xinyew/Moamoa_CPAP_PI_hardware/kmm-pmask-control/exports/kmm-pmask-control.pdf

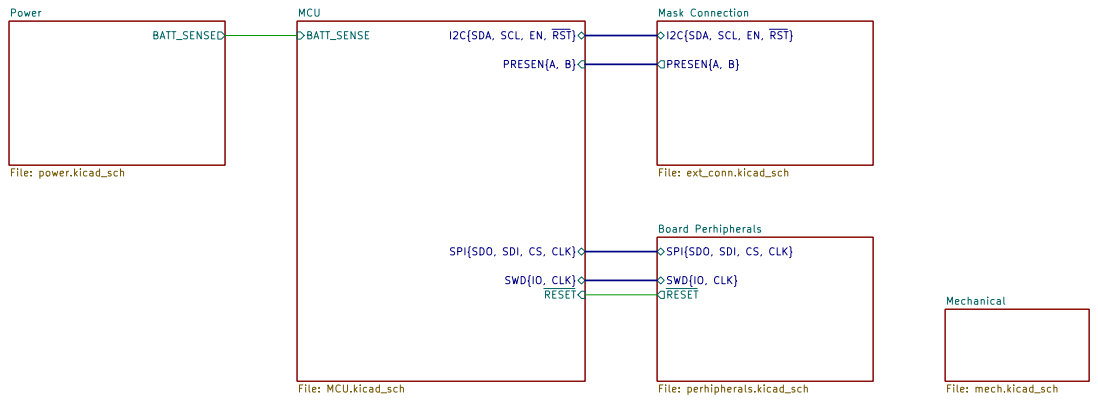
[picture p1: page 1]

SWD{IO, CLK} RESET PRESEN{A, B} BATT_SENSE MCU

I2C{SDA, SCL, EN, RST}

File: ext_conn.kicad_sch SPI{SDO, SDI, CS, CLK}

SWD{IO, CLK} RESET Board Perhipherals File: perhipherals.kicad_sch

SPI{SDO, SDI, CS, CLK}

Aiden Lee [piman PCB]
Ka Moamoa Lab, Georgia Institute of Technology
Sheet: /
File: kmm-pmask-control.kicad_sch
Title: Patient Monitoring Mask Control Board

Size: A4 | Rev: 2.0
KiCad E.D.A. 10.0.4 | Id: 1/6

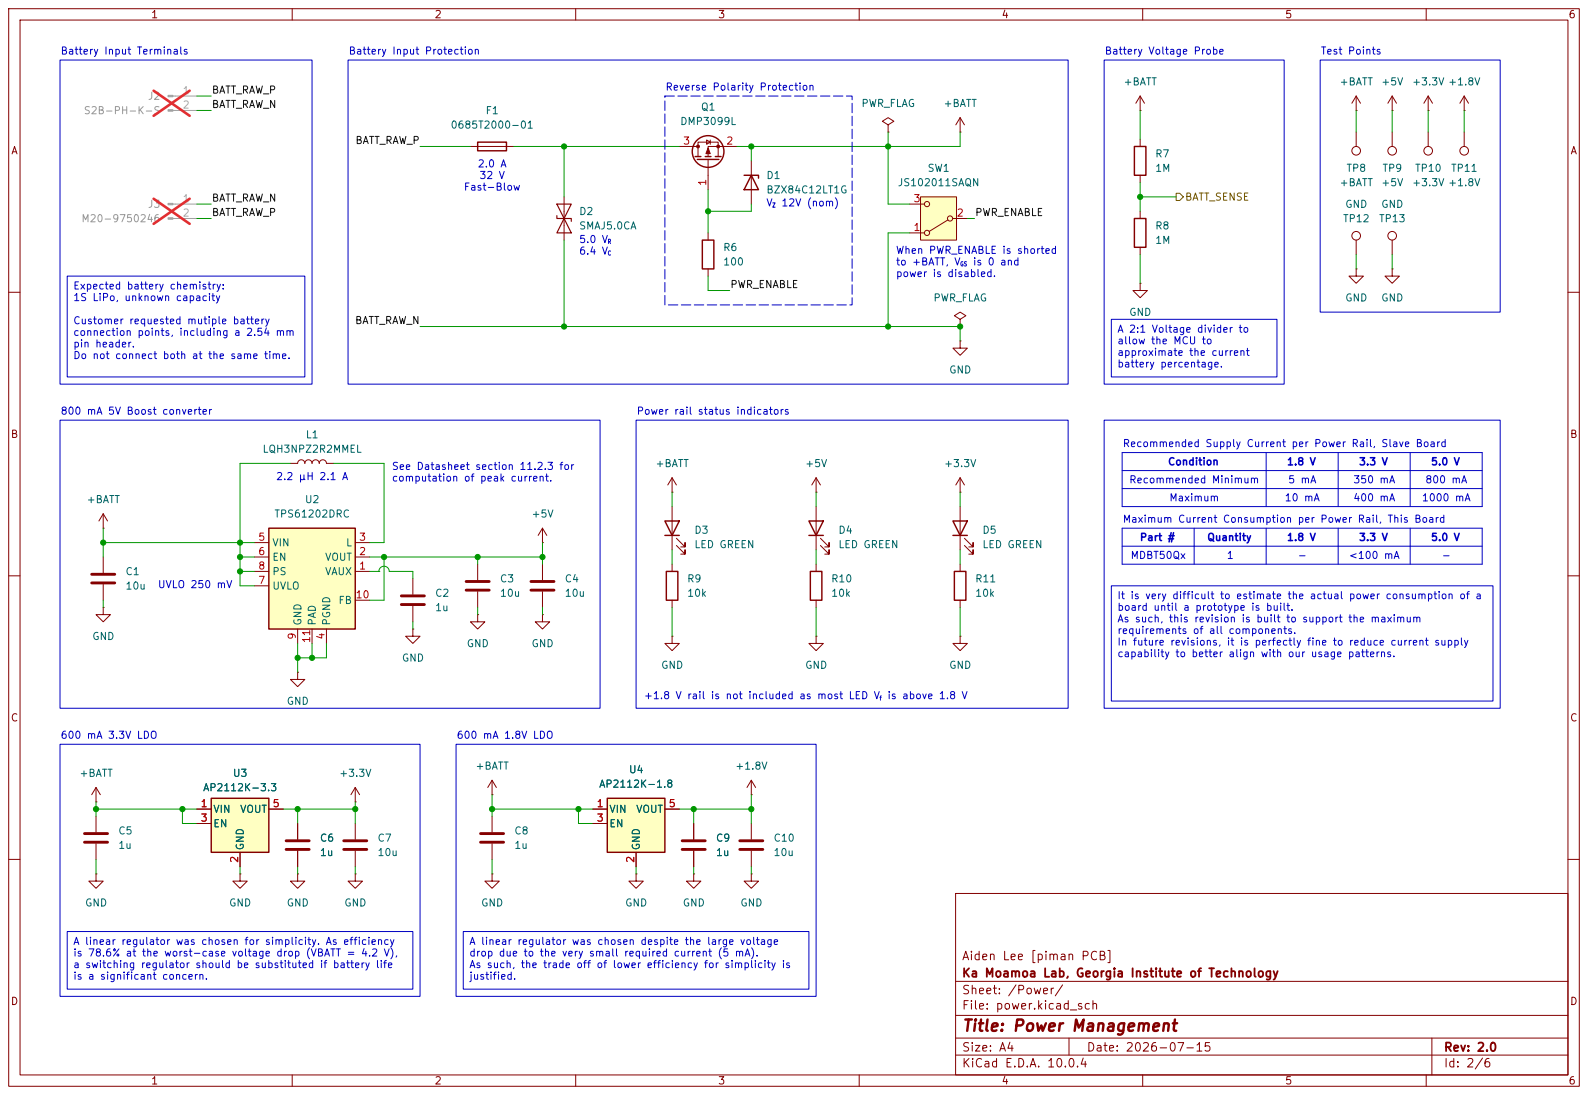
[picture p2: page 2]

to +BATT, VGS is 0 and

power is disabled. 600 mA 1.8V LDO

Expected battery chemistry: 1S LiPo, unknown capacity Customer requested mutiple battery connection points, including a 2.54 mm

GND
A 2:1 Voltage divider to
allow the MCU to

approximate the current battery percentage. A linear regulator was chosen for simplicity. As efficiency

Aiden Lee [piman PCB] C3

It is very difficult to estimate the actual power consumption of a
board until a prototype is built. As such, this revision is built to support the maximum

requirements of all components.
In future revisions, it is perfectly fine to reduce current supply

capability to better align with our usage patterns. A linear regulator was chosen despite the large voltage

is 78.6% at the worst-case voltage drop (VBATT = 4.2 V), a switching regulator should be substituted if battery life

drop due to the very small required current (5 mA). As such, the trade off of lower efficiency for simplicity is

Ka Moamoa Lab, Georgia Institute of Technology
Sheet: /Power/
File: power.kicad_sch
Title: Power Management

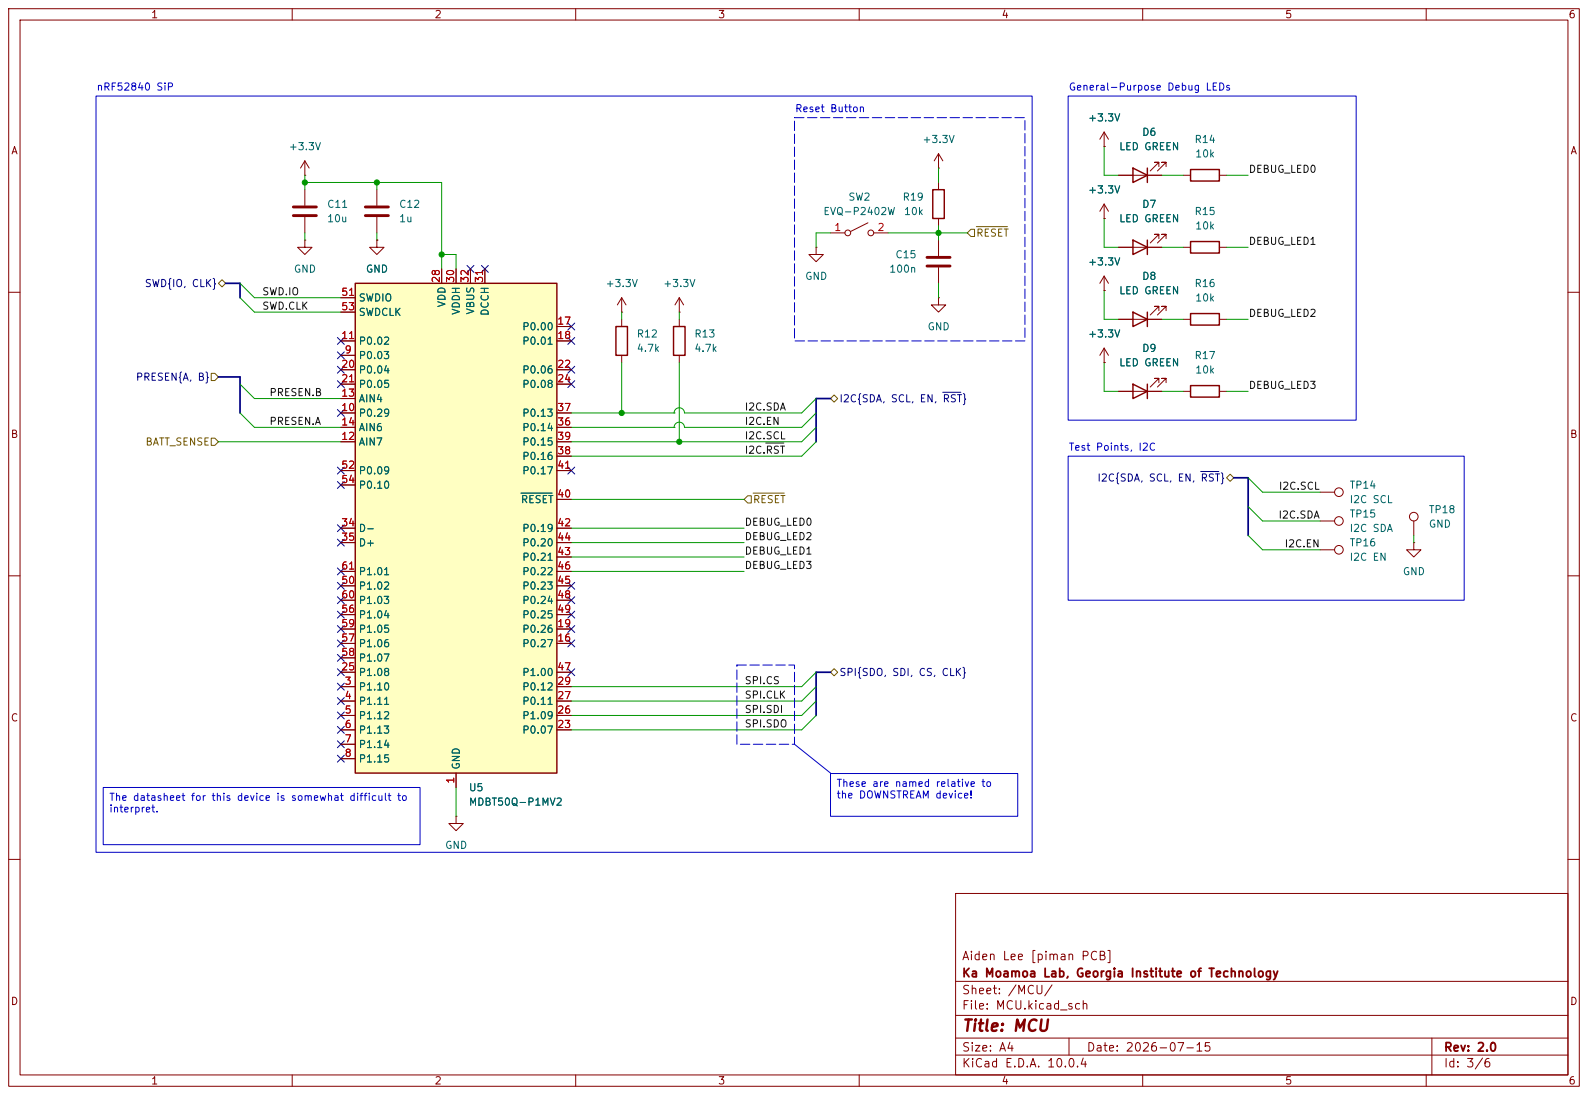
[picture p3: page 3]

I2C{SDA, SCL, EN, RST} SWD.IO
I2C.SCL SWD.CLK

I2C{SDA, SCL, EN, RST}

These are named relative to

Aiden Lee [piman PCB]
Ka Moamoa Lab, Georgia Institute of Technology
Sheet: /MCU/
File: MCU.kicad_sch
Title: MCU

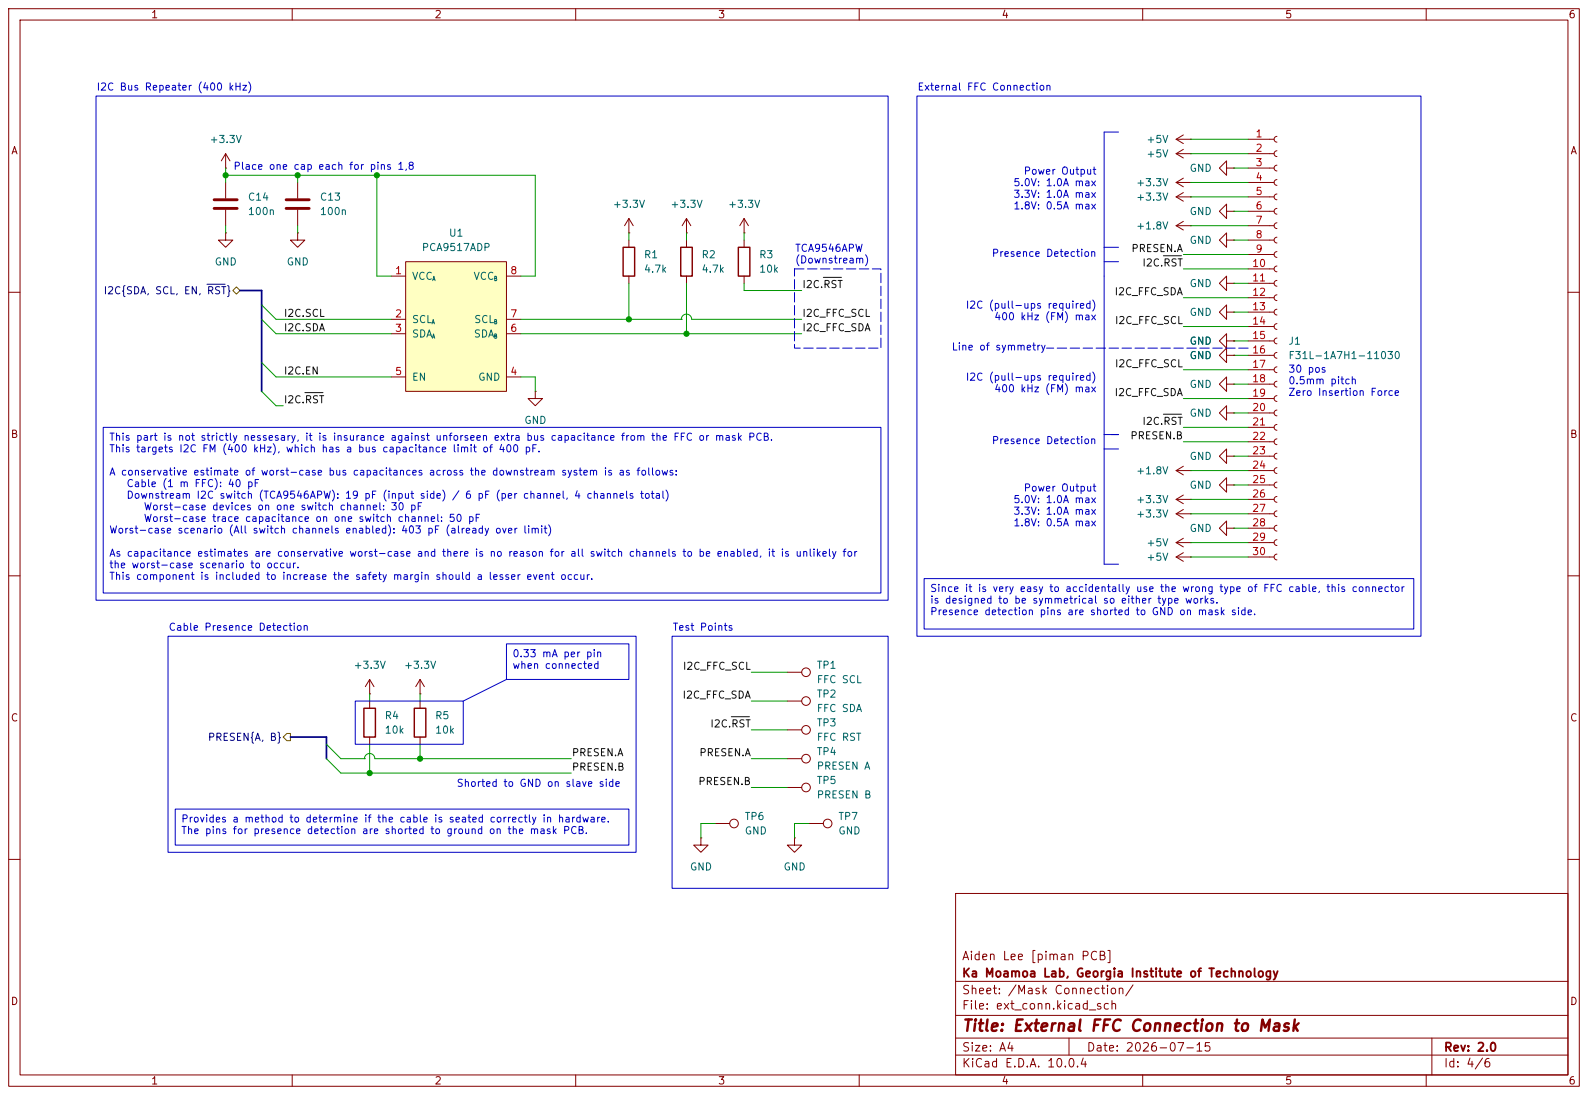
[picture p4: page 4]

(Downstream) Shorted to GND on slave side

I2C{SDA, SCL, EN, RST}

I2C_FFC_SDA Provides a method to determine if the cable is seated correctly in hardware. The pins for presence detection are shorted to ground on the mask PCB. 0.33 mA per pin when connected

I2C (pull-ups required) 400 kHz (FM) max Power Output 5.0V: 1.0A max 3.3V: 1.0A max 1.8V: 0.5A max

This part is not strictly nessesary, it is insurance against unforseen extra bus capacitance from the FFC or mask PCB. This targets I2C FM (400 kHz), which has a bus capacitance limit of 400 pF. A conservative estimate of worst-case bus capacitances across the downstream system is as follows: Cable (1 m FFC): 40 pF Downstream I2C switch (TCA9546APW): 19 pF (input side) / 6 pF (per channel, 4 channels total) Worst-case devices on one switch channel: 30 pF Worst-case trace capacitance on one switch channel: 50 pF Worst-case scenario (All switch channels enabled): 403 pF (already over limit) As capacitance estimates are conservative worst-case and there is no reason for all switch channels to be enabled, it is unlikely for

is designed to be symmetrical so either type works. Presence detection pins are shorted to GND on mask side. Test Points

Aiden Lee [piman PCB]
Ka Moamoa Lab, Georgia Institute of Technology
Sheet: /Mask Connection/
File: ext_conn.kicad_sch
Title: External FFC Connection to Mask

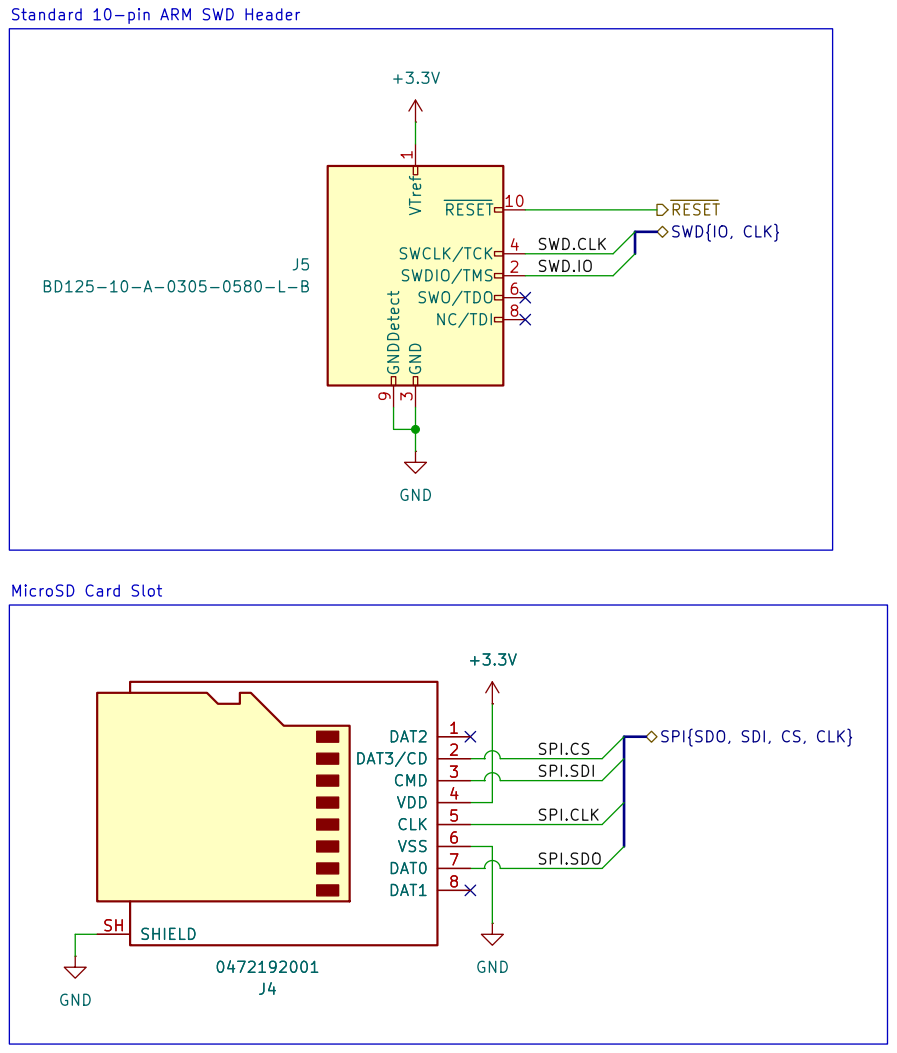
[picture p5: page 5]

SWD{IO, CLK} RESET SPI.CS

Aiden Lee [piman PCB] +3.3V GND

SPI{SDO, SDI, CS, CLK}

SPI.SDI SPI.CLK

Ka Moamoa Lab, Georgia Institute of Technology
Sheet: /Board Perhipherals/
File: perhipherals.kicad_sch
Title: On-Board Perhipherals

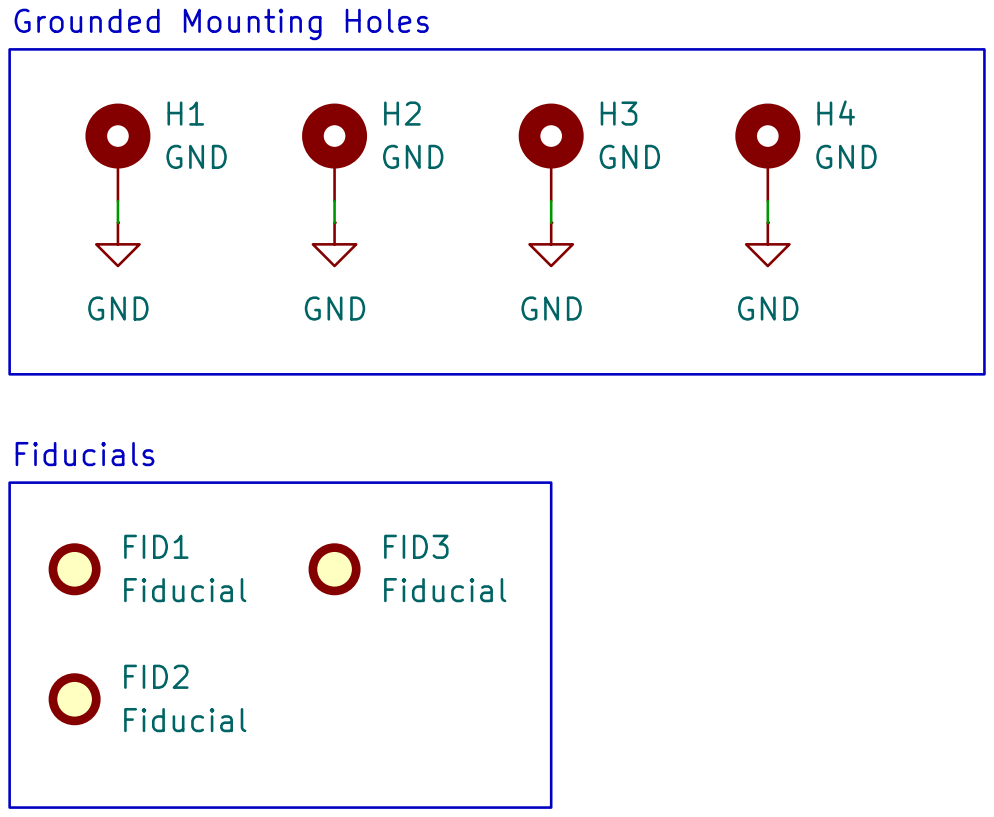
[picture p6: page 6]

Grounded Mounting Holes Fiducials

Aiden Lee [piman PCB]
Ka Moamoa Lab, Georgia Institute of Technology
Sheet: /Mechanical/
File: mech.kicad_sch
Title:
