xinyew/Moamoa_CPAP_PI_hardware/kmm-pmask-mask/exports/kmm-pmask-mask.pdf

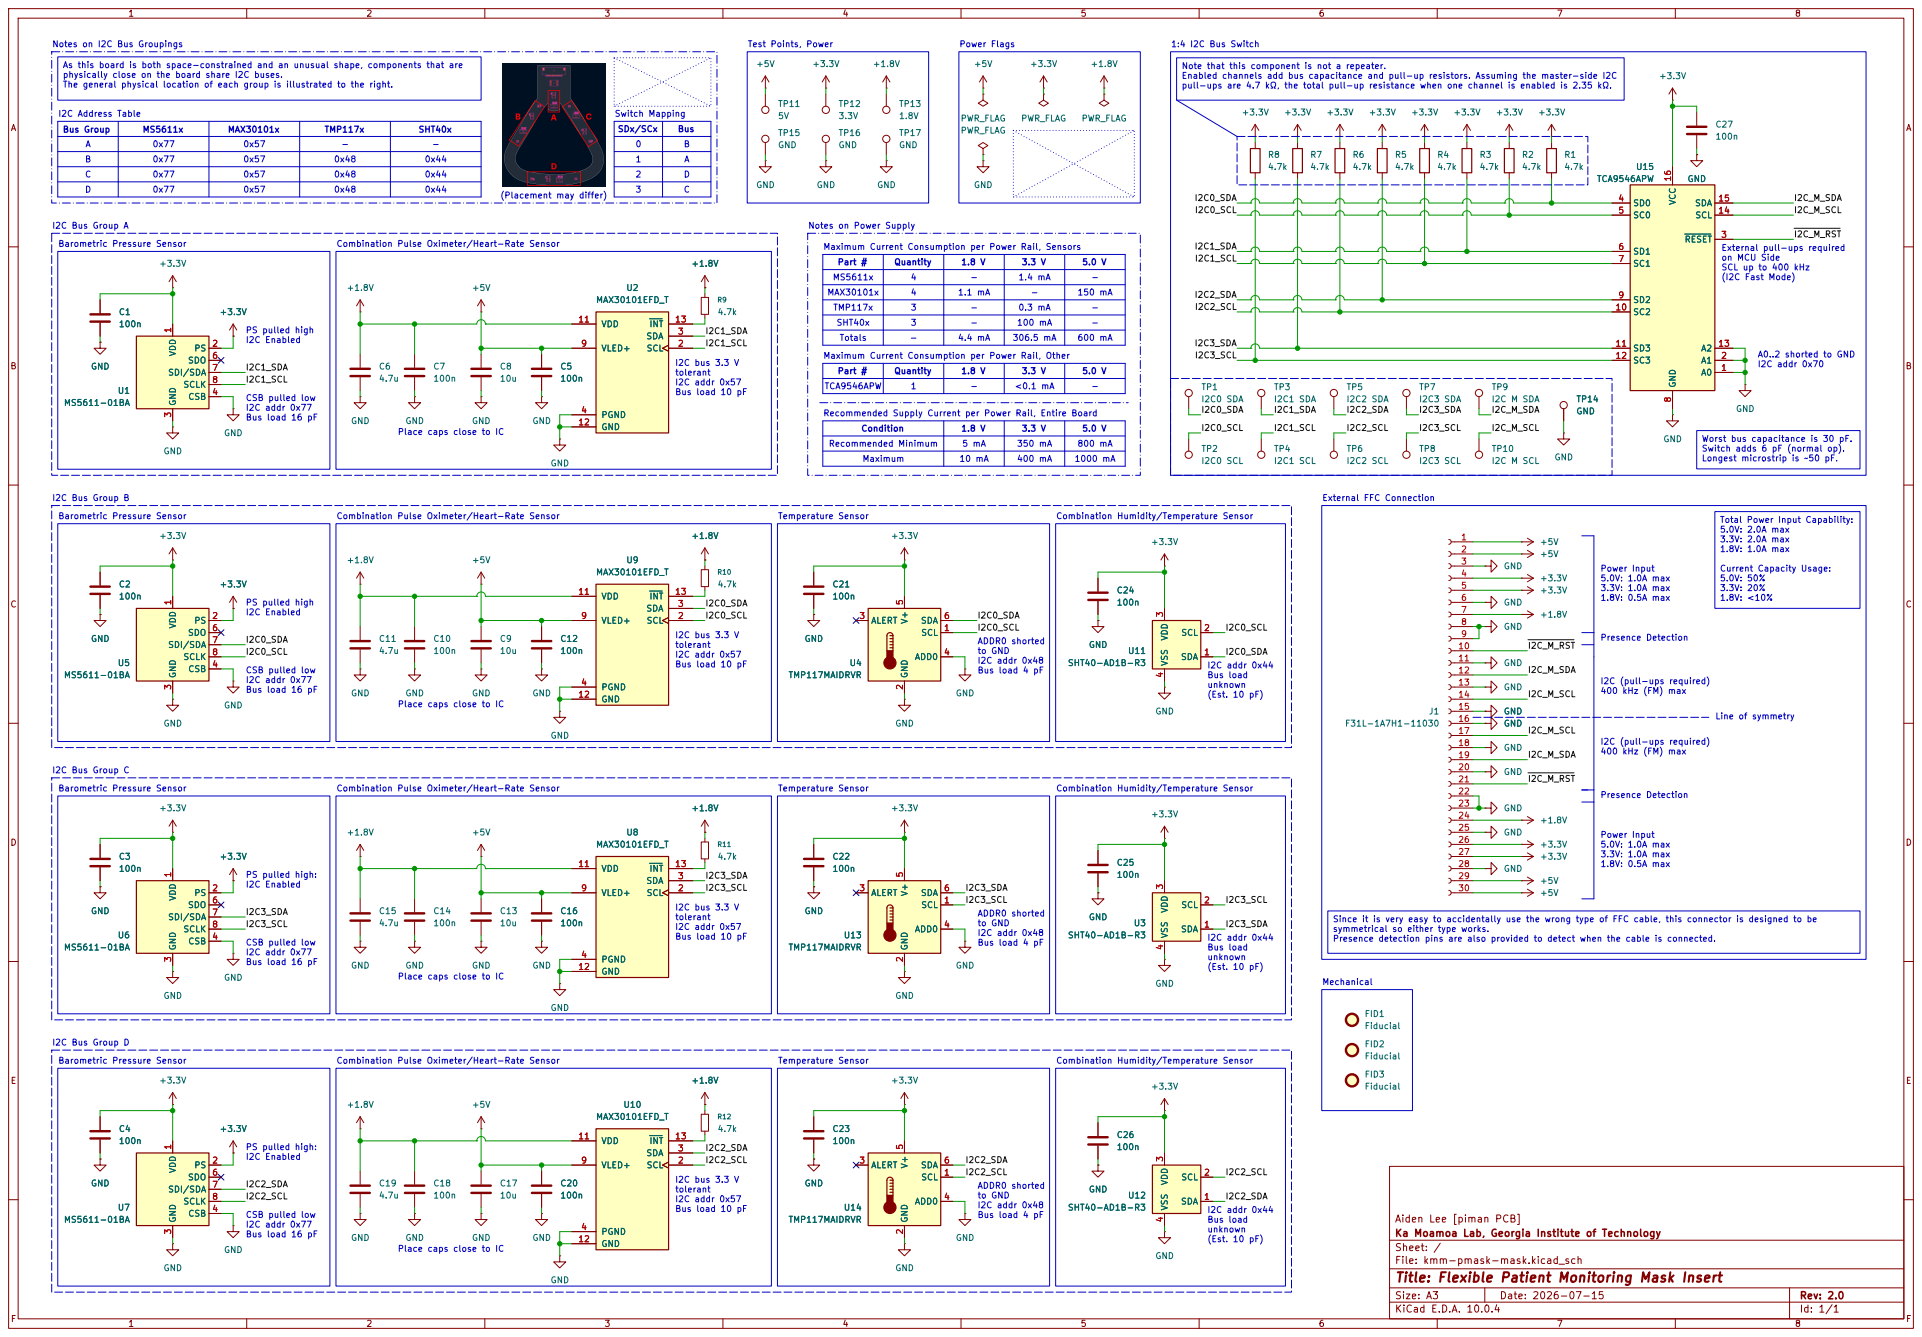
[picture p7: page 1]

Notes on I2C Bus Groupings

Power Flags Maximum Current Consumption per Power Rail, Sensors Maximum Current Consumption per Power Rail, Other

As this board is both space-constrained and an unusual shape, components that are physically close on the board share I2C buses. The general physical location of each group is illustrated to the right.

Longest microstrip is ~50 pF. Note that this component is not a repeater. Enabled channels add bus capacitance and pull-up resistors. Assuming the master-side I2C

(Placement may differ)
GND +3.3V C1
I2C Enabled PS pulled high
I2C Enabled CSB pulled low

Part # | Quantity 4 | 1.8 V - | 1.4 mA 3.3 V | 5.0 V MS5611x -

on MCU Side SCL up to 400 kHz

(I2C Fast Mode) A0..2 shorted to GND

MAX30101x | 4 | 1.1 mA | - | 150 mA

I2C addr 0x70 Place caps close to IC
100n GND

Recommended Supply Current per Power Rail, Entire Board

(Est. 10 pF) Combination Humidity/Temperature Sensor

Line of symmetry Presence Detection Power Input 5.0V: 1.0A max 3.3V: 1.0A max 1.8V: 0.5A max Presence Detection Power Input 5.0V: 1.0A max 3.3V: 1.0A max 1.8V: 0.5A max

I2C addr 0x57 Bus load 10 pF Barometric Pressure Sensor

I2C (pull-ups required) 400 kHz (FM) max

Place caps close to IC

Combination Pulse Oximeter/Heart-Rate Sensor PS pulled high:

I2C bus 3.3 V
tolerant
I2C addr 0x57 Bus load 10 pF

Since it is very easy to accidentally use the wrong type of FFC cable, this connector is designed to be
symmetrical so either type works. Presence detection pins are also provided to detect when the cable is connected.

Combination Pulse Oximeter/Heart-Rate Sensor

Aiden Lee [piman PCB] C18

to GND
I2C addr 0x48 Bus load 4 pF

unknown (Est. 10 pF)

Ka Moamoa Lab, Georgia Institute of Technology
Sheet: /
File: kmm-pmask-mask.kicad_sch
Title: Flexible Patient Monitoring Mask Insert

Size: A3 | Rev: 2.0 | F Date: 2026-07-15
KiCad E.D.A. 10.0.4 | Id: 1/1
