xinyew/Moamoa_CPAP_PI_hardware/kmm-pmask-mask-M/kmm-pmask-mask.kicad_pcb

## KiCad design kmm-pmask-mask-M/kmm-pmask-mask.kicad_pcb (2026-08-24)

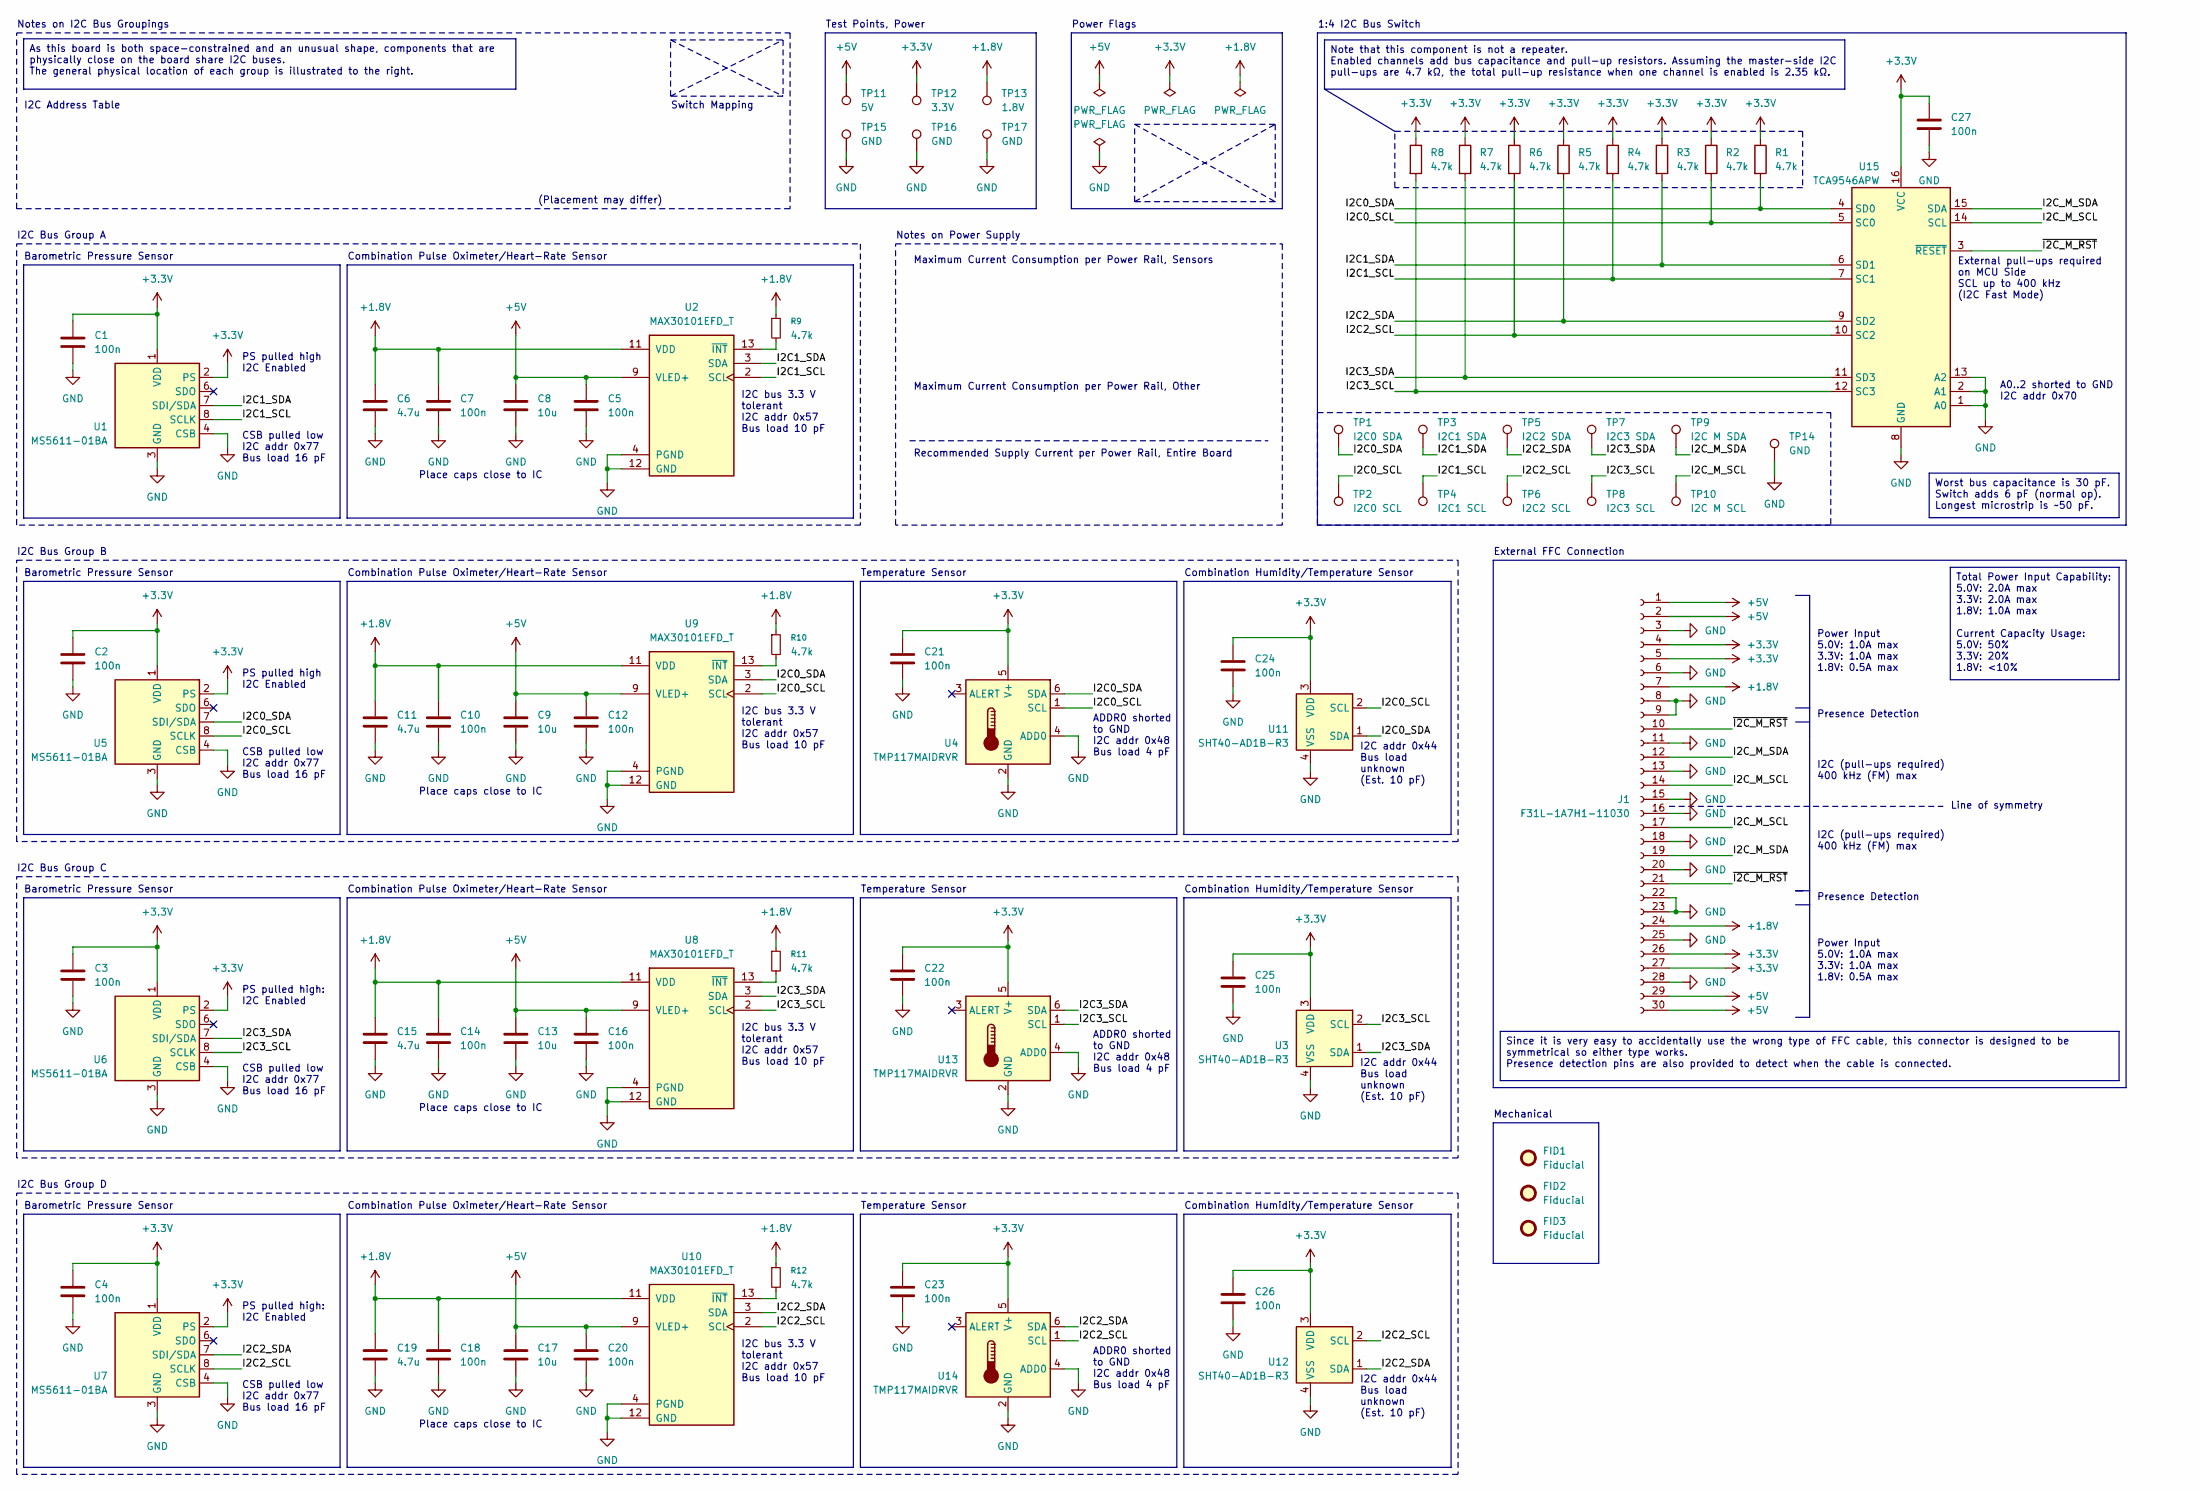
[picture p8: schematic kmm-pmask-mask.kicad_sch, Flexible Patient Monitoring Mask Insert]

Parts:
C1, C2, C3, C4, C5, C7, C10, C12, C14, C16, C18, C20, C21, C22, C23, C24, C25, C26, C27: 100n; C_0201_0603Metric_Pad0.64x0.40mm_HandSolder
C6, C11, C15, C19: 4.7u; C_0402_1005Metric_Pad0.74x0.62mm_HandSolder
C8, C9, C13, C17: 10u; C_0402_1005Metric_Pad0.74x0.62mm_HandSolder
FID1, FID2, FID3: Fiducial; Fiducial_1mm_Mask3mm
J1: F31L-1A7H1-11030; AMPHENOL_F31L-1A7H1-11030; Manufacturer P/N F31L-1A7H1-11030
R1, R2, R3, R4, R5, R6, R7, R8, R9, R10, R11, R12: 4.7k; R_0201_0603Metric_Pad0.64x0.40mm_HandSolder
TP1: I2C0 SDA; TestPoint_Pad_D1.0mm
TP2: I2C0 SCL; TestPoint_Pad_D1.0mm
TP3: I2C1 SDA; TestPoint_Pad_D1.0mm
TP4: I2C1 SCL; TestPoint_Pad_D1.0mm
TP5: I2C2 SDA; TestPoint_Pad_D1.0mm
TP6: I2C2 SCL; TestPoint_Pad_D1.0mm
TP7: I2C3 SDA; TestPoint_Pad_D1.0mm
TP8: I2C3 SCL; TestPoint_Pad_D1.0mm
TP9: I2C M SDA; TestPoint_Pad_D1.0mm
TP10: I2C M SCL; TestPoint_Pad_D1.0mm
TP11: 5V; TestPoint_Pad_D1.0mm
TP12: 3.3V; TestPoint_Pad_D1.0mm
TP13: 1.8V; TestPoint_Pad_D1.0mm
TP14, TP15, TP16, TP17: GND; TestPoint_Pad_D1.0mm
U1, U5, U6, U7: MS5611-01BA; LGA-8_3x5mm_P1.25mm; Manufacturer P/N MS561101BA03-50
U2, U8, U9, U10: MAX30101EFD_T; Manufacturer P/N MAX30101EFD+T
U3, U11, U12: SHT40-AD1B-R3; Sensirion_DFN-4_1.5x1.5mm_P0.8mm_SHT4x_NoCentralPad; Manufacturer P/N SHT40-AD1B-R3
U4, U13, U14: TMP117MAIDRVR; WSON-6-1EP_2x2mm_P0.65mm_EP1x1.6mm; Manufacturer P/N TMP117MAIDRVR
U15: TCA9546APW; TSSOP-16_4.4x5mm_P0.65mm; Manufacturer P/N TCA9546APWR

Connections:
+1.8V: C6.1, C7.1, C10.1, C11.1, C14.1, C15.1, C18.1, C19.1, J1.7, J1.24, R9.1, R10.1, R11.1, R12.1, TP13.1 (1_1), U2.11 (VDD), U8.11 (VDD), U9.11 (VDD), U10.11 (VDD)
+3.3V: C1.1, C2.1, C3.1, C4.1, C21.1, C22.1, C23.1, C24.1, C25.1, C26.1, C27.1, J1.4, J1.5, J1.26, J1.27, R1.1, R2.1, R3.1, R4.1, R5.1, R6.1, R7.1, R8.1, TP12.1 (1_1), U1.1 (VDD), U1.2 (PS), U3.3 (VDD), U4.5 (V+), U5.1 (VDD), U5.2 (PS), U6.1 (VDD), U6.2 (PS), U7.1 (VDD), U7.2 (PS), U11.3 (VDD), U12.3 (VDD), U13.5 (V+), U14.5 (V+), U15.16 (VCC)
+5V: C5.1, C8.1, C9.1, C12.1, C13.1, C16.1, C17.1, C20.1, J1.1, J1.2, J1.29, J1.30, TP11.1 (1_1), U2.9 (VLED+), U2.10 (VLED+), U8.9 (VLED+), U8.10 (VLED+), U9.9 (VLED+), U9.10 (VLED+), U10.9 (VLED+), U10.10 (VLED+)
/I2C0_SCL: R2.2, TP2.1 (1_1), U4.1 (SCL), U5.8 (SCLK), U9.2 (SCL), U11.2 (SCL), U15.5 (SC0)
/I2C0_SDA: R1.2, TP1.1 (1_1), U4.6 (SDA), U5.7 (SDI/SDA), U9.3 (SDA), U11.1 (SDA), U15.4 (SD0)
/I2C1_SCL: R4.2, TP4.1 (1_1), U1.8 (SCLK), U2.2 (SCL), U15.7 (SC1)
/I2C1_SDA: R3.2, TP3.1 (1_1), U1.7 (SDI/SDA), U2.3 (SDA), U15.6 (SD1)
/I2C2_SCL: R6.2, TP6.1 (1_1), U7.8 (SCLK), U10.2 (SCL), U12.2 (SCL), U14.1 (SCL), U15.10 (SC2)
/I2C2_SDA: R5.2, TP5.1 (1_1), U7.7 (SDI/SDA), U10.3 (SDA), U12.1 (SDA), U14.6 (SDA), U15.9 (SD2)
/I2C3_SCL: R8.2, TP8.1 (1_1), U3.2 (SCL), U6.8 (SCLK), U8.2 (SCL), U13.1 (SCL), U15.12 (SC3)
/I2C3_SDA: R7.2, TP7.1 (1_1), U3.1 (SDA), U6.7 (SDI/SDA), U8.3 (SDA), U13.6 (SDA), U15.11 (SD3)
/I2C_M_SCL: J1.14, J1.17, TP10.1 (1_1), U15.14 (SCL)
/I2C_M_SDA: J1.12, J1.19, TP9.1 (1_1), U15.15 (SDA)
/~I2C_M_RST: J1.10, J1.21, U15.3 (~RESET)
GND: C1.2, C2.2, C3.2, C4.2, C5.2, C6.2, C7.2, C8.2, C9.2, C10.2, C11.2, C12.2, C13.2, C14.2, C15.2, C16.2, C17.2, C18.2, C19.2, C20.2, C21.2, C22.2, C23.2, C24.2, C25.2, C26.2, C27.2, J1.3, J1.6, J1.8, J1.9, J1.11, J1.13, J1.15, J1.16, J1.18, J1.20, J1.22, J1.23, J1.25, J1.28, TP14.1 (1_1), TP15.1 (1_1), TP16.1 (1_1), TP17.1 (1_1), U1.3 (GND), U1.4 (CSB), U1.5 (CSB), U2.4 (PGND), U2.12 (GND), U3.4 (VSS), U4.2 (GND), U4.4 (ADD0), U5.3 (GND), U5.4 (CSB), U5.5 (CSB), U6.3 (GND), U6.4 (CSB), U6.5 (CSB), U7.3 (GND), U7.4 (CSB), U7.5 (CSB), U8.4 (PGND), U8.12 (GND), U9.4 (PGND), U9.12 (GND), U10.4 (PGND), U10.12 (GND), U11.4 (VSS), U12.4 (VSS), U13.2 (GND), U13.4 (ADD0), U14.2 (GND), U14.4 (ADD0), U15.1 (A0), U15.2 (A1), U15.8 (GND), U15.13 (A2)
unnamed: R9.2, U2.13 (~INT)
unnamed: R11.2, U8.13 (~INT)
unnamed: R10.2, U9.13 (~INT)
unnamed: R12.2, U10.13 (~INT)

Notes on the sheet:
Switch Mapping
I2C (pull-ups required) 400 kHz (FM) max
1:4 I2C Bus Switch
Barometric Pressure Sensor
CSB pulled low I2C addr 0x77 Bus load 16 pF
PS pulled high I2C Enabled
Test Points, Power
ADDR0 shorted to GND I2C addr 0x48 Bus load 4 pF
Temperature Sensor
I2C bus 3.3 V tolerant I2C addr 0x57 Bus load 10 pF
(Placement may differ)
Presence Detection
Notes on Power Supply
I2C Bus Group C
Place caps close to IC
Combination Pulse Oximeter/Heart-Rate Sensor
External FFC Connection
Power Input 5.0V: 1.0A max 3.3V: 1.0A max 1.8V: 0.5A max
Maximum Current Consumption per Power Rail, Sensors
I2C Bus Group D
I2C Bus Group B
I2C addr 0x44 Bus load unknown (Est. 10 pF)
PS pulled high: I2C Enabled
Power Flags
Maximum Current Consumption per Power Rail, Other
Combination Humidity/Temperature Sensor
Line of symmetry
Recommended Supply Current per Power Rail, Entire Board
I2C Bus Group A
Mechanical
External pull-ups required on MCU Side SCL up to 400 kHz (I2C Fast Mode)
Notes on I2C Bus Groupings
I2C Address Table
A0..2 shorted to GND I2C addr 0x70
Since it is very easy to accidentally use the wrong type of FFC cable, this connector is designed to be symmetrical so either type works. Presence detection pins are also provided to detect when the cable is connected.
As this board is both space-constrained and an unusual shape, components that are physically close on the board share I2C buses. The general physical location of each group is illustrated to the right.
Note that this component is not a repeater. Enabled channels add bus capacitance and pull-up resistors. Assuming the master-side I2C pull-ups are 4.7 kΩ, the total pull-up resistance when one channel is enabled is 2.35 kΩ.
Total Power Input Capability: 5.0V: 2.0A max 3.3V: 2.0A max 1.8V: 1.0A max Current Capacity Usage: 5.0V: 50% 3.3V: 20% 1.8V: <10%
Worst bus capacitance is 30 pF. Switch adds 6 pF (normal op). Longest microstrip is ~50 pF.

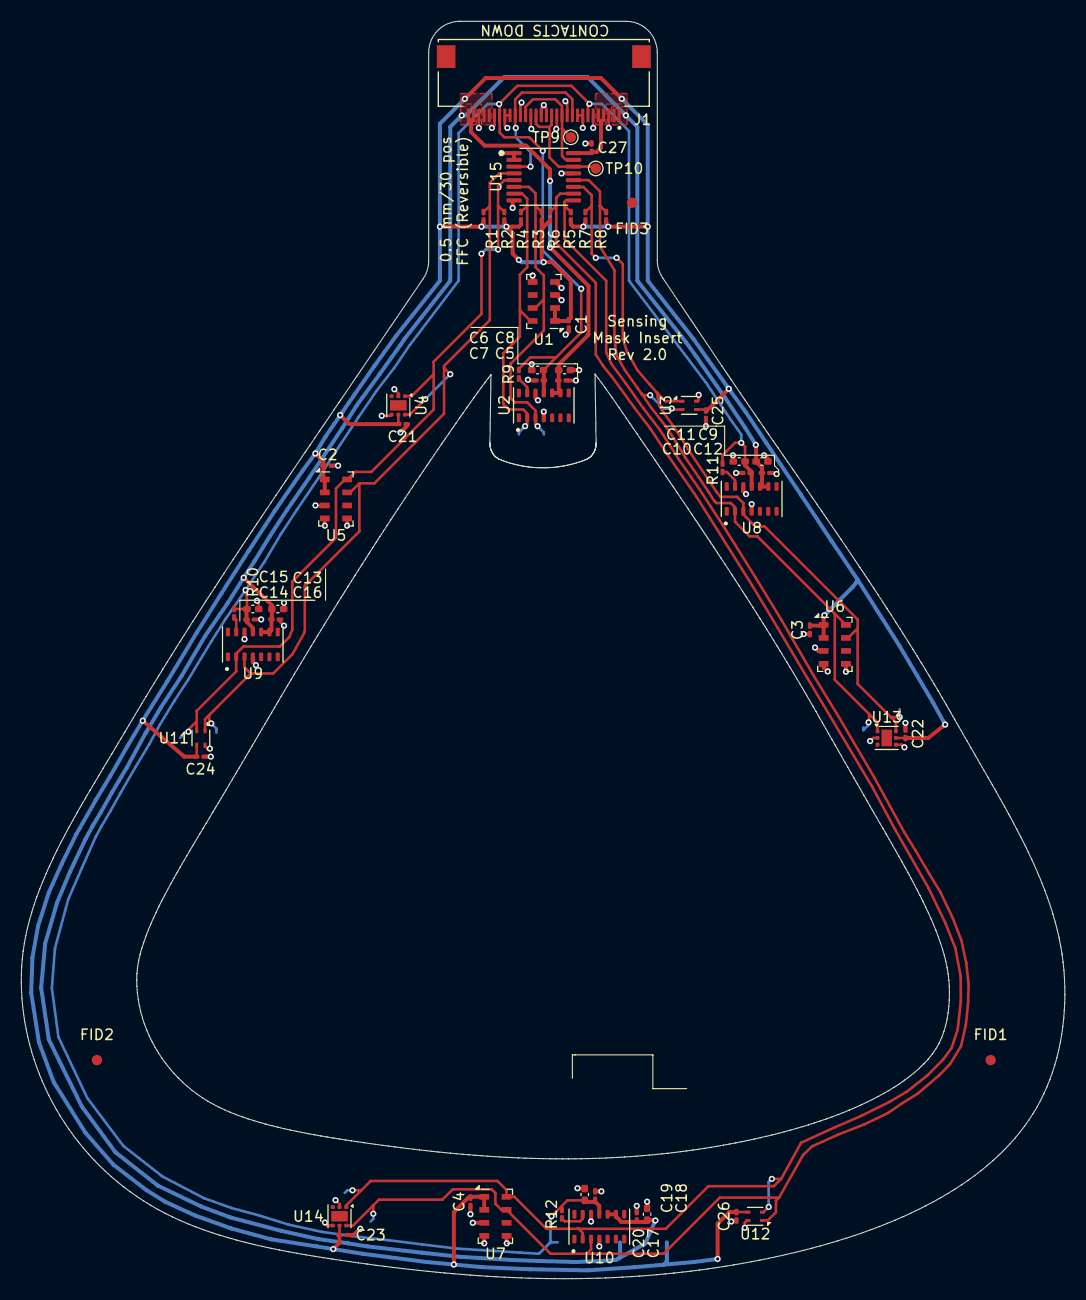
[picture p9: board kmm-pmask-mask.kicad_pcb from above]

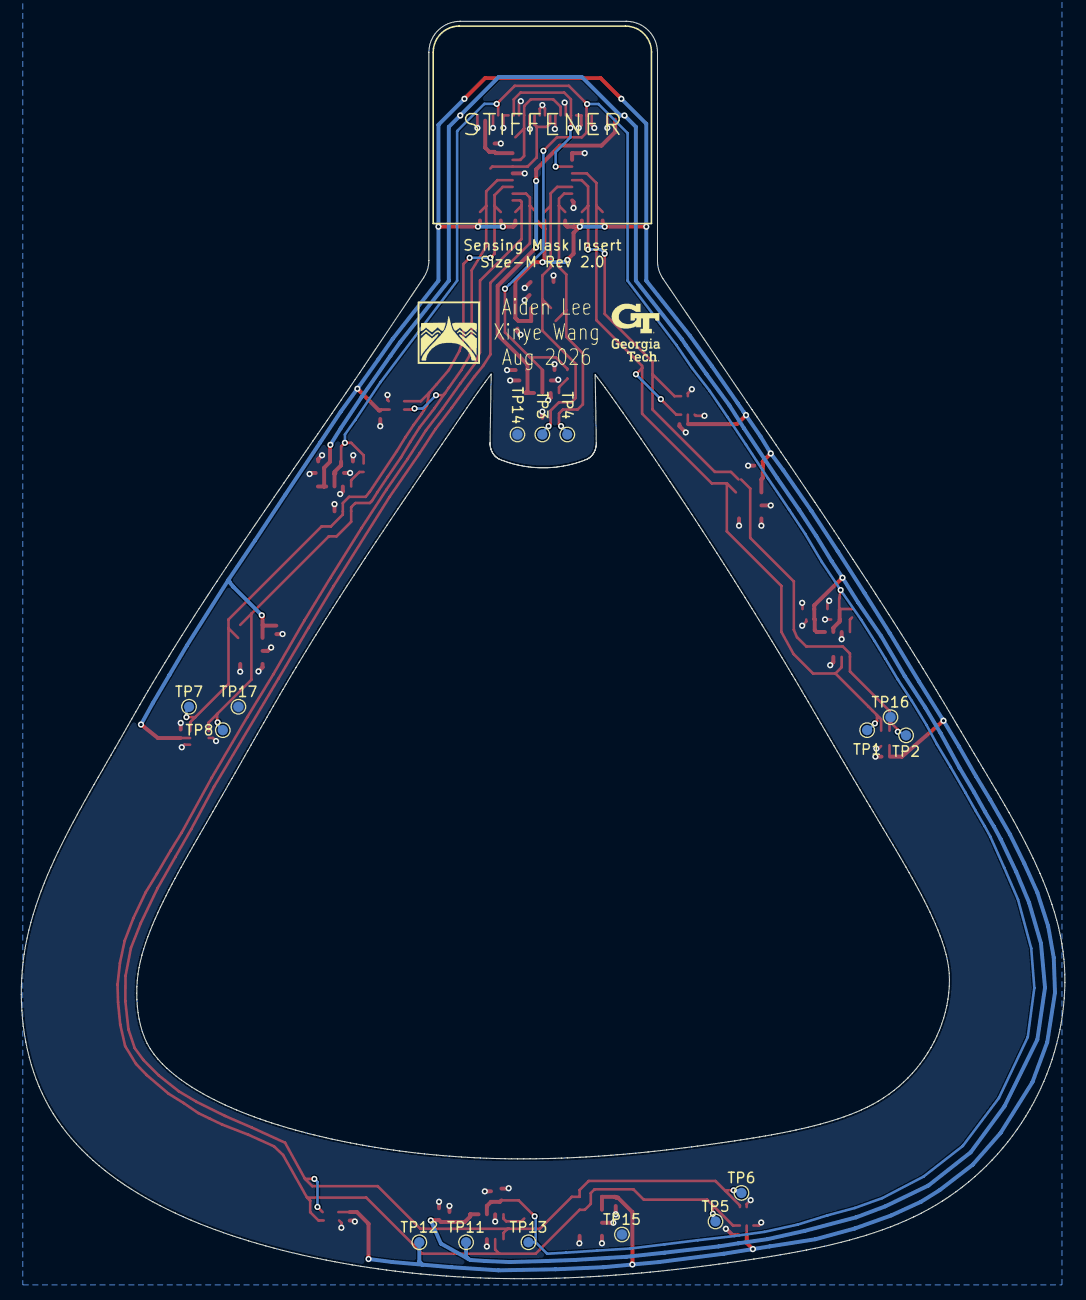
[picture p10: board kmm-pmask-mask.kicad_pcb from below]

Board: 2 copper layers, 100.4 x 121.0 mm, 75 parts (15 on the bottom side), 19 nets.
