xinyew/Moamoa_CPAP_PI_hardware/kmm-pmask-control/kmm-pmask-control.kicad_pcb

## KiCad design kmm-pmask-control/kmm-pmask-control.kicad_pcb (2026-07-20)

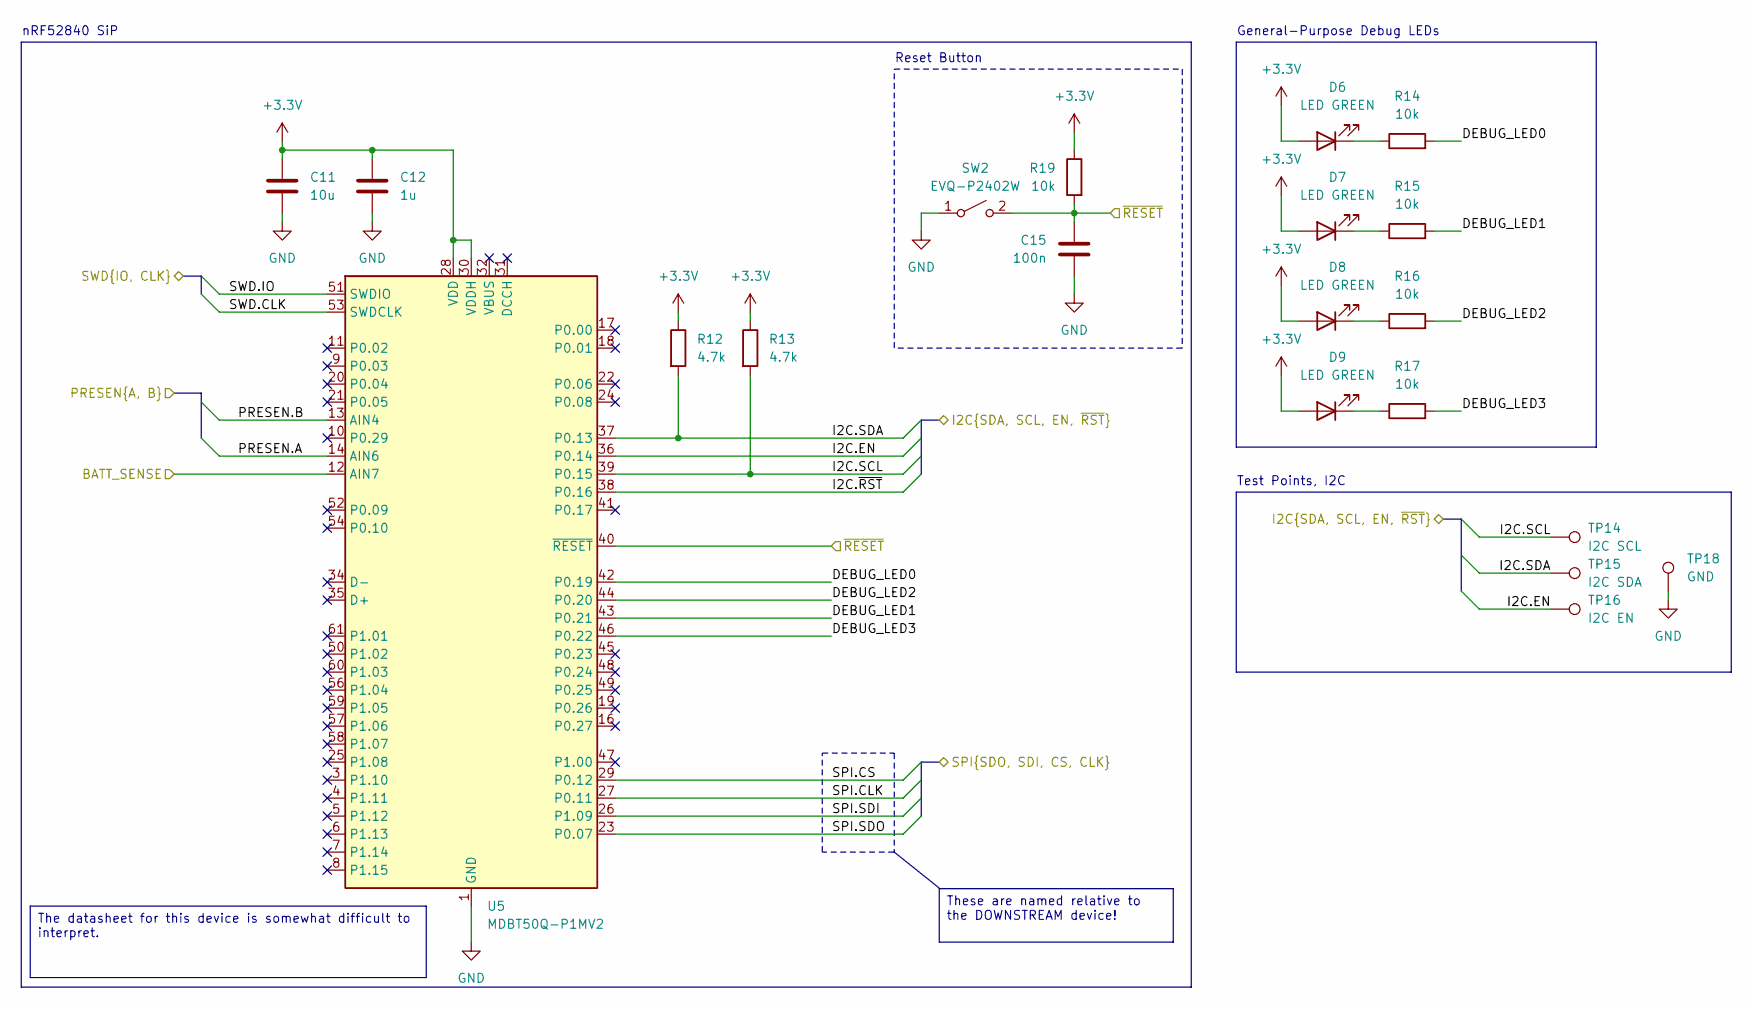
[picture p11: schematic MCU.kicad_sch]

Parts:
C11: 10u; C_0603_1608Metric_Pad1.08x0.95mm_HandSolder
C12: 1u; C_0402_1005Metric_Pad0.74x0.62mm_HandSolder
C15: 100n; C_0402_1005Metric_Pad0.74x0.62mm_HandSolder
D6, D7, D8, D9: LED GREEN; LED_0603_1608Metric_Pad1.05x0.95mm_HandSolder; Manufacturer P/N LTST-C190GKT
R12, R13: 4.7k; R_0402_1005Metric_Pad0.72x0.64mm_HandSolder
R14, R15, R16, R17, R19: 10k; R_0402_1005Metric_Pad0.72x0.64mm_HandSolder
SW2: EVQ-P2402W; SW_SPST_EVQP2_ShortPushTravel_H2.5mm; Manufacturer P/N EVQ-P2402W
TP14: I2C SCL; TestPoint_Pad_D1.0mm
TP15: I2C SDA; TestPoint_Pad_D1.0mm
TP16: I2C EN; TestPoint_Pad_D1.0mm
TP18: GND; TestPoint_Pad_D1.0mm
U5: MDBT50Q-P1MV2; Raytac_MDBT50Q; Manufacturer P/N MDBT50Q-P1MV2

Connections:
+3.3V: C11.1, C12.1, D6.2 (A), D7.2 (A), D8.2 (A), D9.2 (A), R12.1, R13.1, R19.1, U5.28 (VDD), U5.30 (VDDH); also elsewhere on the board
/Board Perhipherals/SPI.CLK: U5.27 (P0.11); also elsewhere on the board
/Board Perhipherals/SPI.CS: U5.29 (P0.12); also elsewhere on the board
/Board Perhipherals/SPI.SDI: U5.26 (P1.09); also elsewhere on the board
/Board Perhipherals/SPI.SDO: U5.23 (P0.07); also elsewhere on the board
/Board Perhipherals/SWD.CLK: U5.53 (SWDCLK); also elsewhere on the board
/Board Perhipherals/SWD.IO: U5.51 (SWDIO); also elsewhere on the board
/Board Perhipherals/~RESET: C15.1, R19.2, SW2.2 (B), U5.40 (~RESET); also elsewhere on the board
/MCU/BATT_SENSE: U5.12 (AIN7); also elsewhere on the board
/MCU/DEBUG_LED0: R14.2, U5.42 (P0.19)
/MCU/DEBUG_LED1: R15.2, U5.43 (P0.21)
/MCU/DEBUG_LED2: R16.2, U5.44 (P0.20)
/MCU/DEBUG_LED3: R17.2, U5.46 (P0.22)
/MCU/I2C.EN: TP16.1 (1_1), U5.36 (P0.14); also elsewhere on the board
/MCU/I2C.SCL: R13.2, TP14.1 (1_1), U5.39 (P0.15); also elsewhere on the board
/MCU/I2C.SDA: R12.2, TP15.1 (1_1), U5.37 (P0.13); also elsewhere on the board
/MCU/I2C.~RST: U5.38 (P0.16); also elsewhere on the board
/MCU/PRESEN.A: U5.14 (AIN6); also elsewhere on the board
/MCU/PRESEN.B: U5.13 (AIN4); also elsewhere on the board
GND: C11.2, C12.2, C15.2, SW2.1 (A), TP18.1 (1_1), U5.1 (GND), U5.2 (GND), U5.15 (GND), U5.33 (GND), U5.55 (GND); also elsewhere on the board
unnamed: D6.1 (K), R14.1
unnamed: D7.1 (K), R15.1
unnamed: D8.1 (K), R16.1
unnamed: D9.1 (K), R17.1

Notes on the sheet:
nRF52840 SiP
Reset Button
General-Purpose Debug LEDs
Test Points, I2C
The datasheet for this device is somewhat difficult to interpret.
These are named relative to the DOWNSTREAM device!

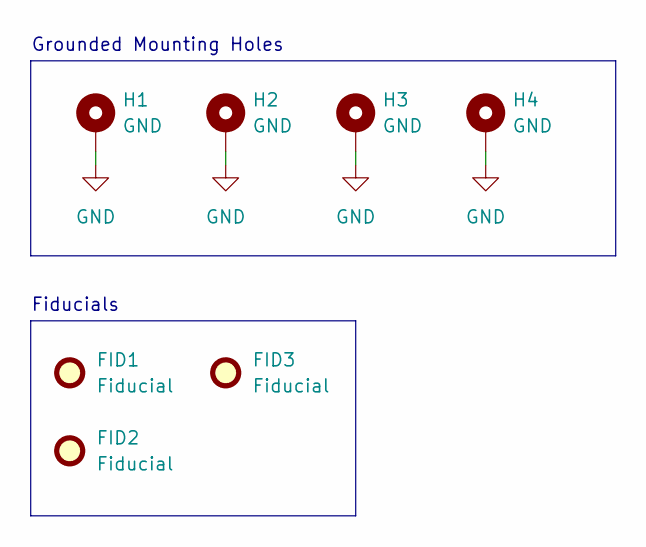
[picture p12: schematic mech.kicad_sch]

Parts:
FID1, FID2, FID3: Fiducial; Fiducial_1mm_Mask3mm
H1, H2, H3, H4: GND; MountingHole_3.2mm_M3_Pad

Connections:
GND: H1.1 (1_1), H2.1 (1_1), H3.1 (1_1), H4.1 (1_1); also elsewhere on the board

Notes on the sheet:
Grounded Mounting Holes
Fiducials

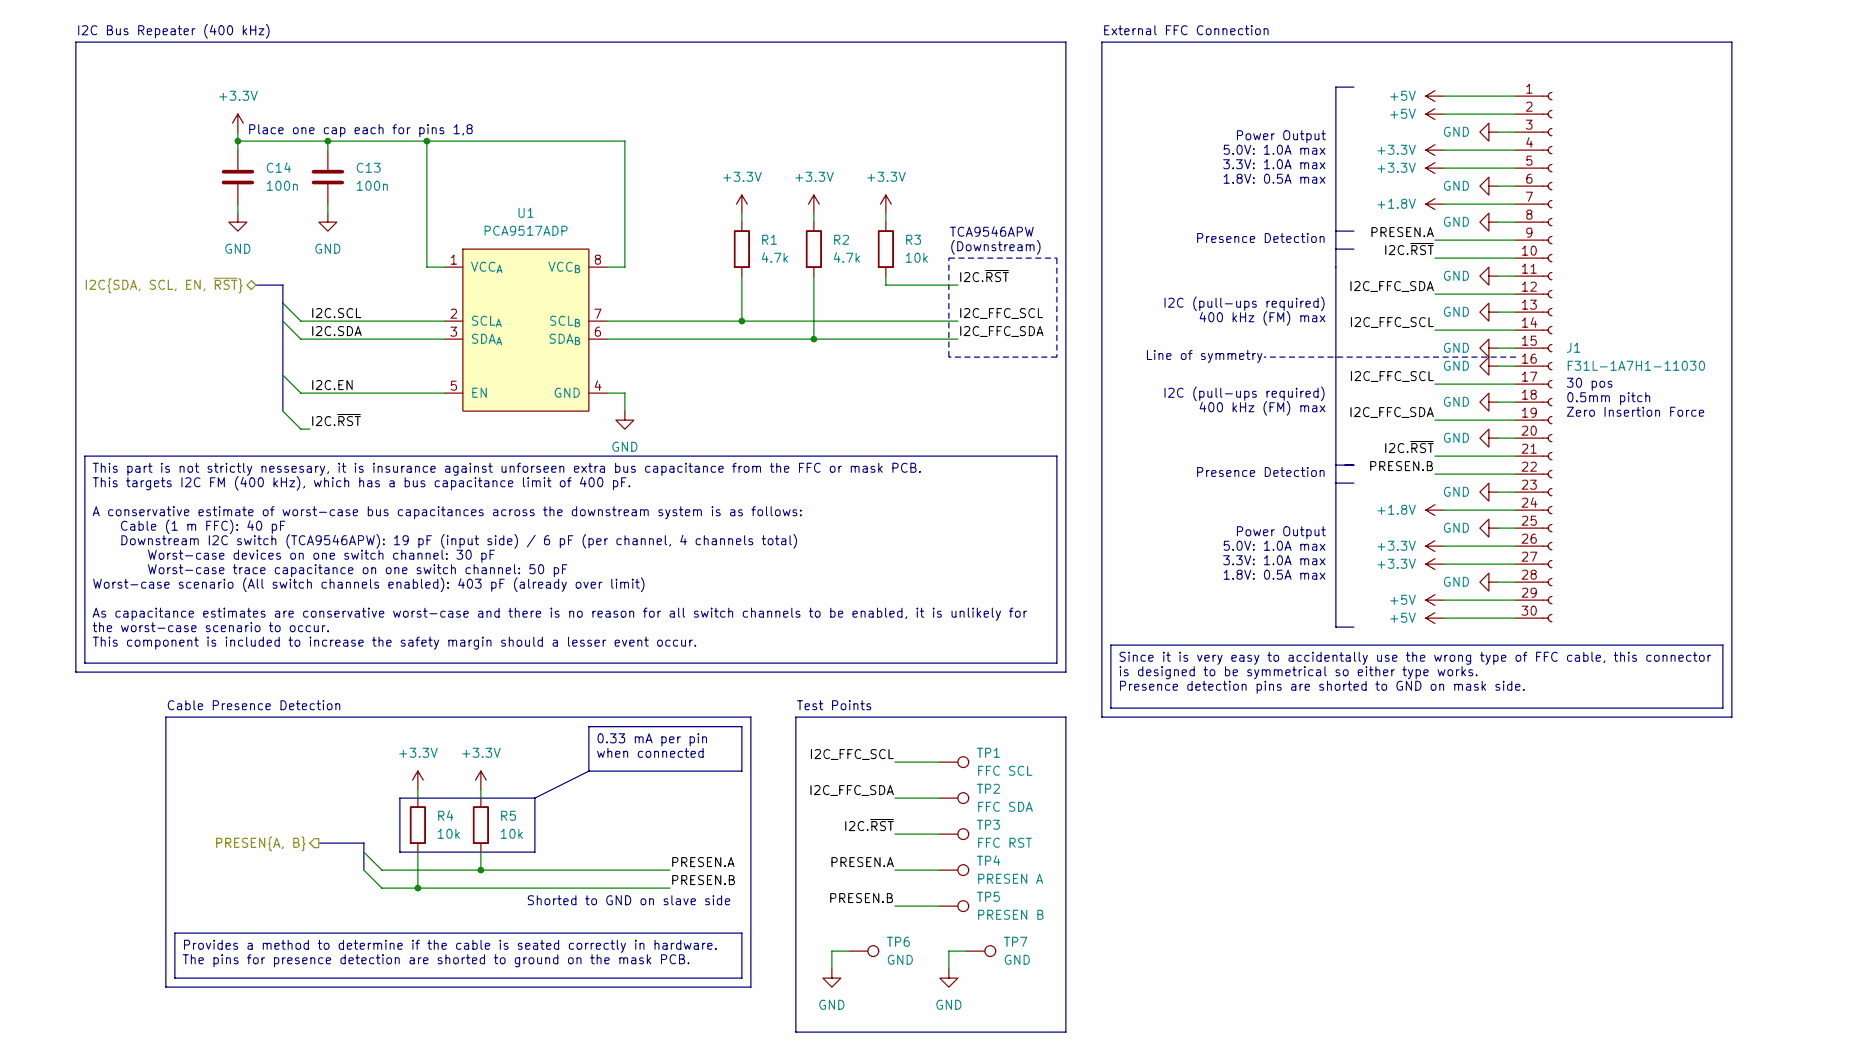
[picture p13: schematic ext_conn.kicad_sch, External FFC Connection to Mask]

Parts:
C13, C14: 100n; C_0402_1005Metric_Pad0.74x0.62mm_HandSolder
J1: F31L-1A7H1-11030; AMPHENOL_F31L-1A7H1-11030; Manufacturer P/N F31L-1A7H1-11030
R1, R2: 4.7k; R_0402_1005Metric_Pad0.72x0.64mm_HandSolder
R3, R4, R5: 10k; R_0402_1005Metric_Pad0.72x0.64mm_HandSolder
TP1: FFC SCL; TestPoint_Pad_D1.0mm
TP2: FFC SDA; TestPoint_Pad_D1.0mm
TP3: FFC RST; TestPoint_Pad_D1.0mm
TP4: PRESEN A; TestPoint_Pad_D1.0mm
TP5: PRESEN B; TestPoint_Pad_D1.0mm
TP6, TP7: GND; TestPoint_Pad_D1.0mm
U1: PCA9517ADP; TSSOP-8_3x3mm_P0.65mm; Manufacturer P/N PCA9517ADP,118

Connections:
+1.8V: J1.7, J1.24; also elsewhere on the board
+3.3V: C13.1, C14.1, J1.4, J1.5, J1.26, J1.27, R1.1, R2.1, R3.1, R4.1, R5.1, U1.1 (VCC_{A}), U1.8 (VCC_{B}); also elsewhere on the board
+5V: J1.1, J1.2, J1.29, J1.30; also elsewhere on the board
/MCU/I2C.EN: U1.5 (EN); also elsewhere on the board
/MCU/I2C.SCL: U1.2 (SCL_{A}); also elsewhere on the board
/MCU/I2C.SDA: U1.3 (SDA_{A}); also elsewhere on the board
/MCU/I2C.~RST: J1.10, J1.21, R3.2, TP3.1 (1_1); also elsewhere on the board
/MCU/PRESEN.A: J1.9, R5.2, TP4.1 (1_1); also elsewhere on the board
/MCU/PRESEN.B: J1.22, R4.2, TP5.1 (1_1); also elsewhere on the board
/Mask Connection/I2C_FFC_SCL: J1.14, J1.17, R1.2, TP1.1 (1_1), U1.7 (SCL_{B})
/Mask Connection/I2C_FFC_SDA: J1.12, J1.19, R2.2, TP2.1 (1_1), U1.6 (SDA_{B})
GND: C13.2, C14.2, J1.3, J1.6, J1.8, J1.11, J1.13, J1.15, J1.16, J1.18, J1.20, J1.23, J1.25, J1.28, TP6.1 (1_1), TP7.1 (1_1), U1.4 (GND); also elsewhere on the board

Notes on the sheet:
Place one cap each for pins 1,8
Line of symmetry
30 pos 0.5mm pitch Zero Insertion Force
Power Output 5.0V: 1.0A max 3.3V: 1.0A max 1.8V: 0.5A max
I2C (pull-ups required) 400 kHz (FM) max
Shorted to GND on slave side
Cable Presence Detection
External FFC Connection
Presence Detection
Test Points
TCA9546APW (Downstream)
I2C Bus Repeater (400 kHz)
Since it is very easy to accidentally use the wrong type of FFC cable, this connector is designed to be symmetrical so either type works. Presence detection pins are shorted to GND on mask side.
0.33 mA per pin when connected
This part is not strictly nessesary, it is insurance against unforseen extra bus capacitance from the FFC or mask PCB. This targets I2C FM (400 kHz), which has a bus capacitance limit of 400 pF. A conservative estimate of worst-case bus capacitances across the downstream system is as follows: Cable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
Provides a method to determine if the cable is seated correctly in hardware. The pins for presence detection are shorted to ground on the mask PCB.

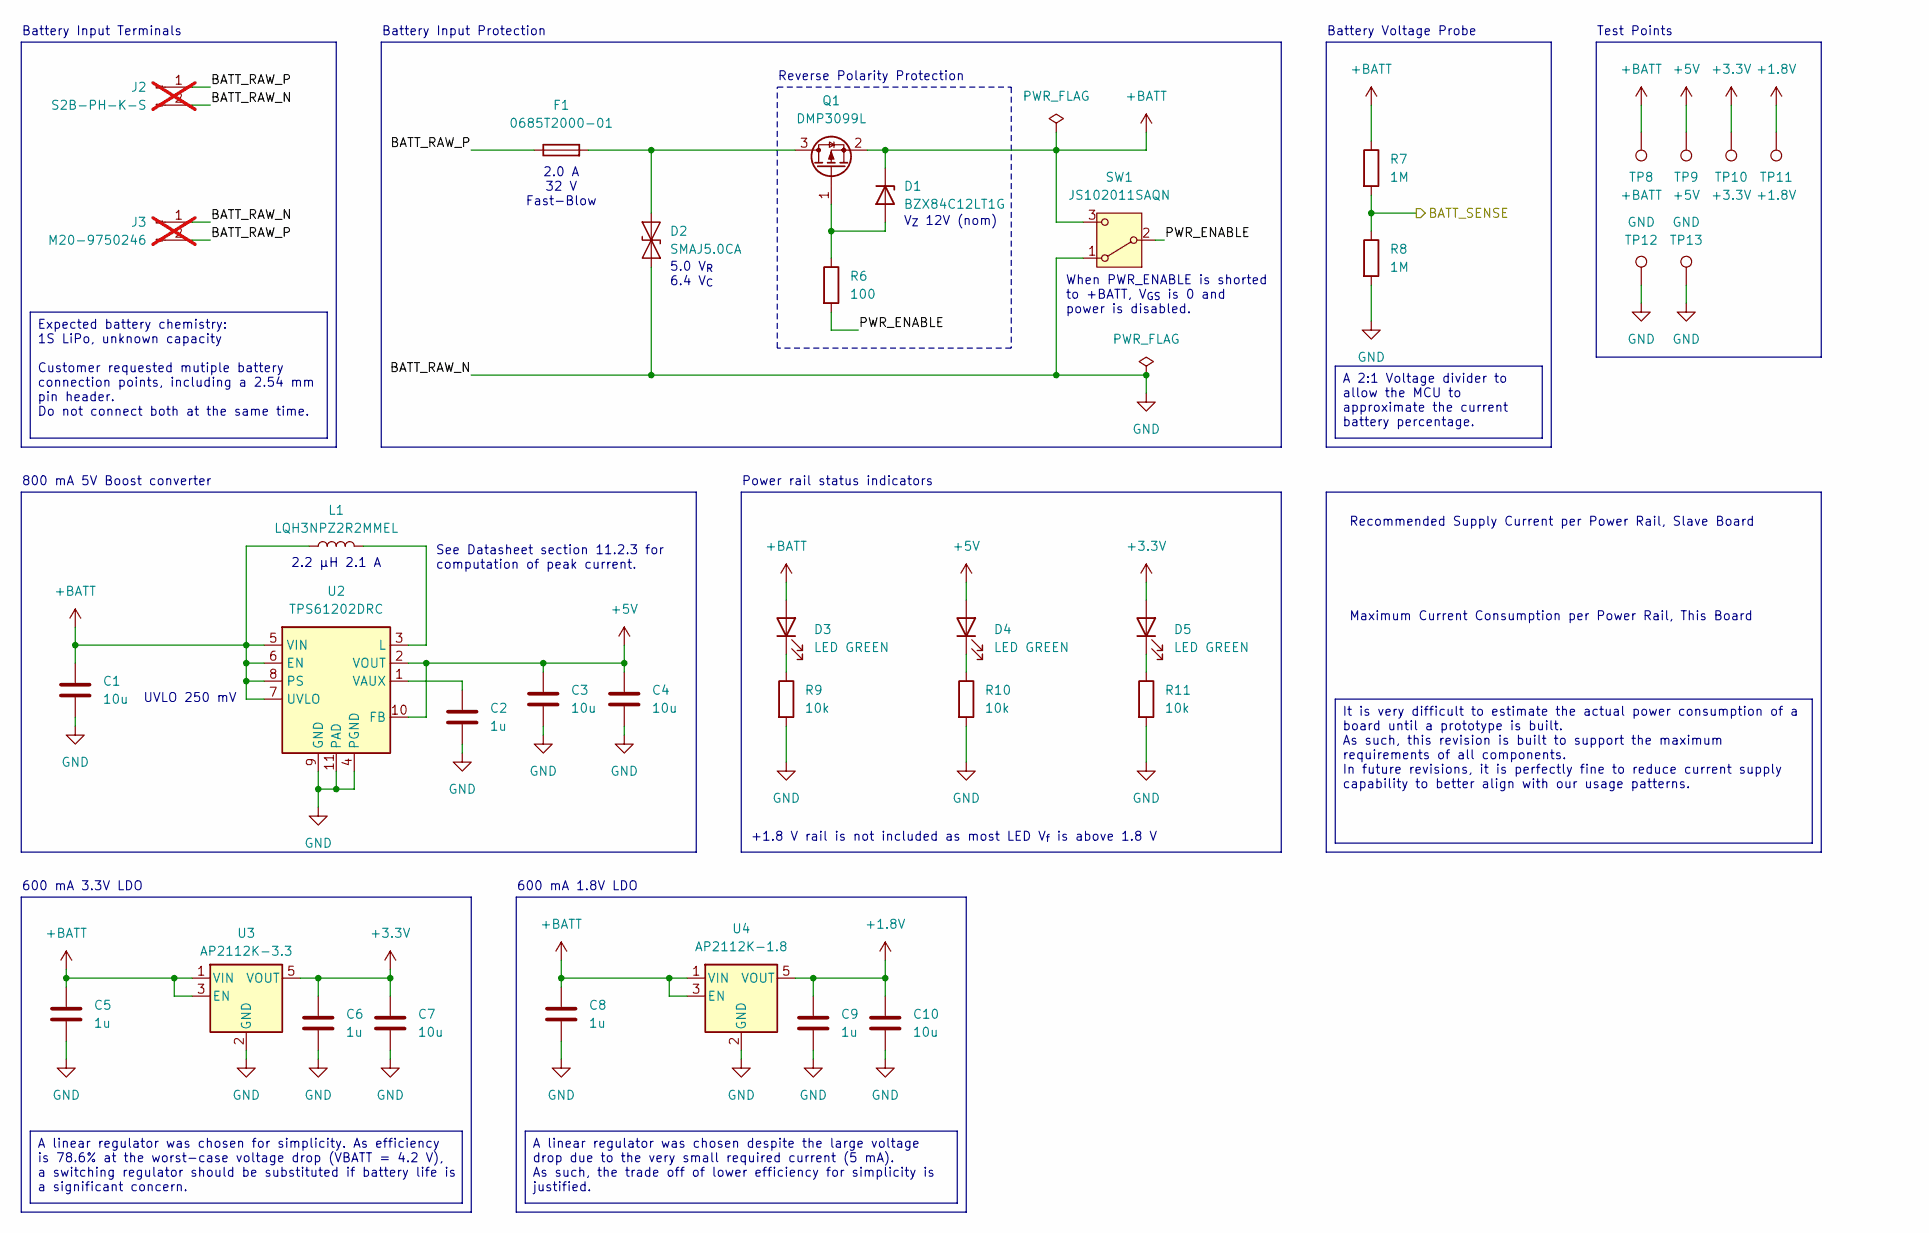
[picture p14: schematic power.kicad_sch, Power Management]

Parts:
C1, C3, C4, C7, C10: 10u; C_0603_1608Metric_Pad1.08x0.95mm_HandSolder
C2, C5, C6, C8, C9: 1u; C_0402_1005Metric_Pad0.74x0.62mm_HandSolder
D1: BZX84C12LT1G; SOT-23; Manufacturer P/N BZX84C12LT1G
D2: SMAJ5.0CA; D_SMA; Manufacturer P/N SMAJ5.0CA
D3, D4, D5: LED GREEN; LED_0603_1608Metric_Pad1.05x0.95mm_HandSolder; Manufacturer P/N LTST-C190GKT
F1: 0685T2000-01; Fuse_1206_3216Metric_Pad1.42x1.75mm_HandSolder; Manufacturer P/N 0685T2000-01
J2: S2B-PH-K-S; JST_PH_S2B-PH-K_1x02_P2.00mm_Horizontal; Manufacturer P/N S2B-PH-K-S; not fitted
J3: M20-9750246; PinHeader_1x02_P2.54mm_Horizontal; Manufacturer P/N M20-9750246; not fitted
L1: LQH3NPZ2R2MMEL; IND_LQH3NPZ2R2MMEL; Manufacturer P/N LQH3NPZ2R2MMEL
Q1: DMP3099L; SOT-23; Manufacturer P/N DMP3099L-13
R6: 100; R_0402_1005Metric_Pad0.72x0.64mm_HandSolder
R7, R8: 1M; R_0402_1005Metric_Pad0.72x0.64mm_HandSolder
R9, R10, R11: 10k; R_0402_1005Metric_Pad0.72x0.64mm_HandSolder
SW1: JS102011SAQN; SW_SPDT_CK_JS102011SAQN; Manufacturer P/N JS102011SAQN
TP8: +BATT; TestPoint_Pad_D1.0mm
TP9: +5V; TestPoint_Pad_D1.0mm
TP10: +3.3V; TestPoint_Pad_D1.0mm
TP11: +1.8V; TestPoint_Pad_D1.0mm
TP12, TP13: GND; TestPoint_Pad_D1.0mm
U2: TPS61202DRC; Texas_S-PVSON-N10_ThermalVias; Manufacturer P/N TPS61202DRCR
U3: AP2112K-3.3; SOT-23-5; Manufacturer P/N AP2112K-3.3TRG1
U4: AP2112K-1.8; SOT-23-5; Manufacturer P/N AP2112K-1.8TRG1

Connections:
+1.8V: C9.1, C10.1, TP11.1 (1_1), U4.5 (VOUT); also elsewhere on the board
+3.3V: C6.1, C7.1, D5.2 (A), TP10.1 (1_1), U3.5 (VOUT); also elsewhere on the board
+5V: C3.1, C4.1, D4.2 (A), TP9.1 (1_1), U2.2 (VOUT), U2.10 (FB); also elsewhere on the board
+BATT: C1.1, C5.1, C8.1, D1.3 (K), D3.2 (A), L1.1, Q1.2 (S), R7.1, SW1.3 (C), TP8.1 (1_1), U2.5 (VIN), U2.6 (EN), U2.7 (UVLO), U2.8 (PS), U3.1 (VIN), U3.3 (EN), U4.1 (VIN), U4.3 (EN)
/MCU/BATT_SENSE: R7.2, R8.1; also elsewhere on the board
/Power/BATT_RAW_P: F1.1, J2.1, J3.2
/Power/PWR_ENABLE: R6.2, SW1.2 (B)
GND: C1.2, C2.2, C3.2, C4.2, C5.2, C6.2, C7.2, C8.2, C9.2, C10.2, D2.1 (A1), J2.2, J3.1, R8.2, R9.2, R10.2, R11.2, SW1.1 (A), TP12.1 (1_1), TP13.1 (1_1), U2.4 (PGND), U2.9 (GND), U2.11 (PAD), U3.2 (GND), U4.2 (GND); also elsewhere on the board
unnamed: D1.1 (A), Q1.1 (G), R6.1
unnamed: D2.2 (A2), F1.2, Q1.3 (D)
unnamed: D3.1 (K), R9.1
unnamed: D4.1 (K), R10.1
unnamed: D5.1 (K), R11.1
unnamed: L1.2, U2.3 (L)
unnamed: C2.1, U2.1 (VAUX)

Notes on the sheet:
Battery Voltage Probe
Maximum Current Consumption per Power Rail, This Board
V_{Z} 12V (nom)
Power rail status indicators
600 mA 3.3V LDO
When PWR_ENABLE is shorted to +BATT, V_{GS} is 0 and power is disabled.
Reverse Polarity Protection
Test Points
600 mA 1.8V LDO
800 mA 5V Boost converter
+1.8 V rail is not included as most LED V_{f} is above 1.8 V
Battery Input Protection
Battery Input Terminals
2.0 A 32 V Fast-Blow
5.0 V_{R} 6.4 V_{C}
Recommended Supply Current per Power Rail, Slave Board
UVLO 250 mV
See Datasheet section 11.2.3 for computation of peak current.
2.2 µH 2.1 A
A linear regulator was chosen for simplicity. As efficiency is 78.6% at the worst-case voltage drop (VBATT = 4.2 V), a switching regulator should be substituted if battery life is a significant concern.
Expected battery chemistry: 1S LiPo, unknown capacity Customer requested mutiple battery connection points, including a 2.54 mm pin header. Do not connect both at the same time.
It is very difficult to estimate the actual power consumption of a board until a prototype is built. As such, this revision is built to support the maximum requirements of all components. In future revisions, it is perfectly fine to reduce current supply capability to better align with our usage pa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
A 2:1 Voltage divider to allow the MCU to approximate the current battery percentage.
A linear regulator was chosen despite the large voltage drop due to the very small required current (5 mA). As such, the trade off of lower efficiency for simplicity is justified.

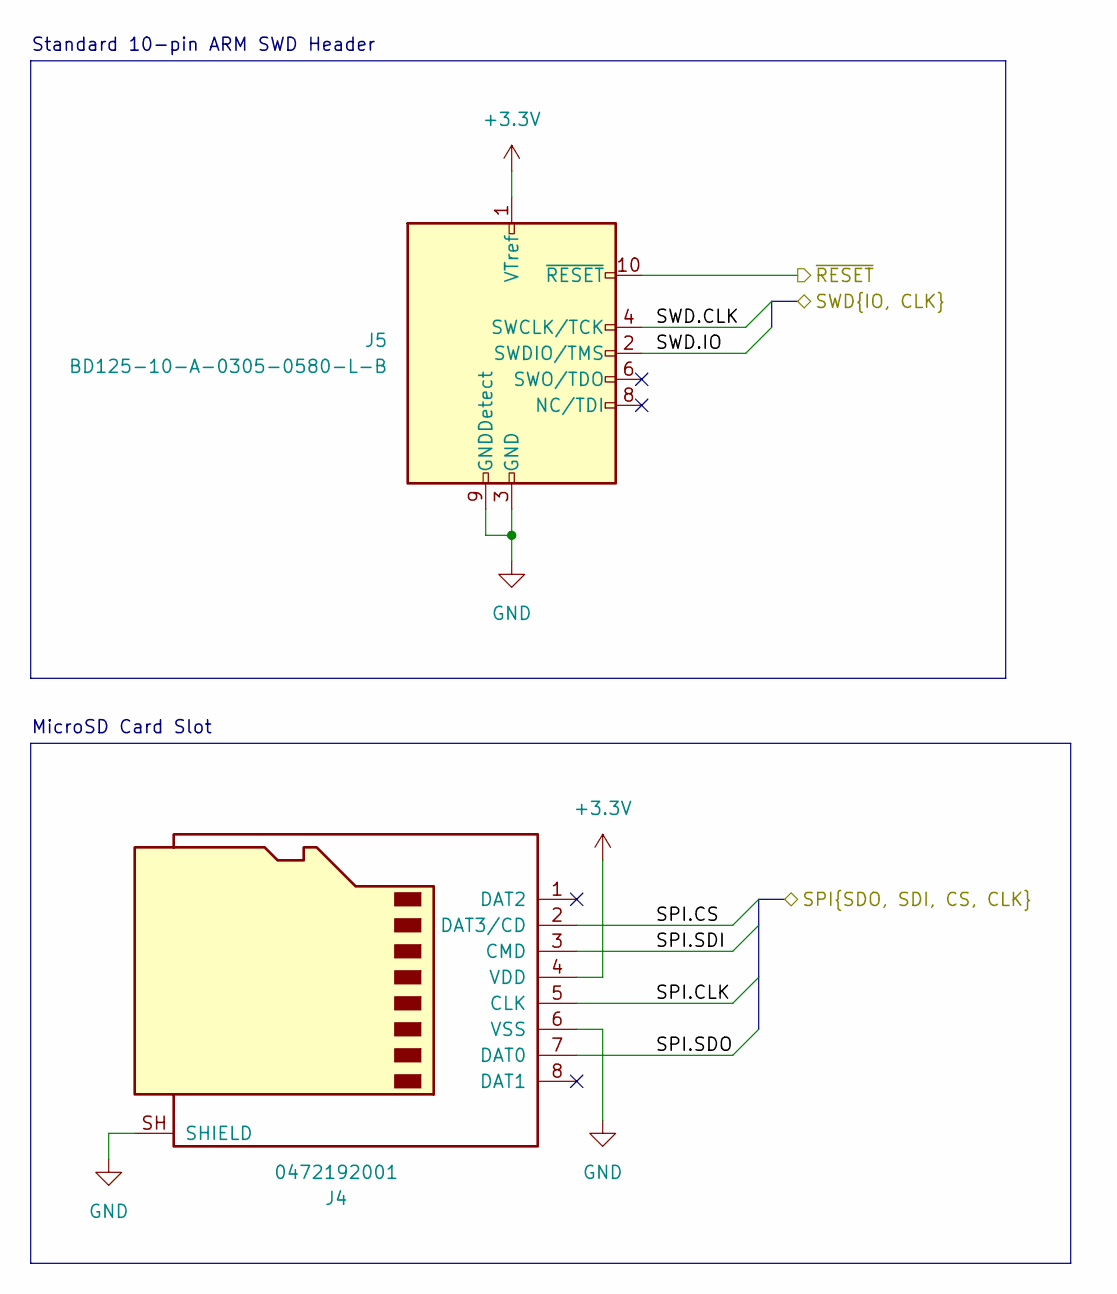
[picture p15: schematic perhipherals.kicad_sch, On-Board Perhipherals]

Parts:
J4: 0472192001; microSD_HC_Molex_47219-2001; Manufacturer P/N 0472192001
J5: BD125-10-A-0305-0580-L-B; PinHeader_2x05_P1.27mm_Vertical_SMD; Manufacturer P/N BD125-10-A-0305-0580-L-B

Connections:
+3.3V: J4.4 (VDD), J5.1 (VTref); also elsewhere on the board
/Board Perhipherals/SPI.CLK: J4.5 (CLK); also elsewhere on the board
/Board Perhipherals/SPI.CS: J4.2 (DAT3/CD); also elsewhere on the board
/Board Perhipherals/SPI.SDI: J4.3 (CMD); also elsewhere on the board
/Board Perhipherals/SPI.SDO: J4.7 (DAT0); also elsewhere on the board
/Board Perhipherals/SWD.CLK: J5.4 (SWCLK/TCK); also elsewhere on the board
/Board Perhipherals/SWD.IO: J5.2 (SWDIO/TMS); also elsewhere on the board
/Board Perhipherals/~RESET: J5.10 (~RESET); also elsewhere on the board
GND: J4.6 (VSS), J4.SH (SHIELD), J5.3 (GND), J5.5 (GND), J5.9 (GNDDetect); also elsewhere on the board

Notes on the sheet:
Standard 10-pin ARM SWD Header
MicroSD Card Slot
