xinyew/Moamoa_CPAP_PI_hardware/kmm-pmask-control/kmm-pmask-control.kicad_pcb

## KiCad design kmm-pmask-control/kmm-pmask-control.kicad_pcb (continued)

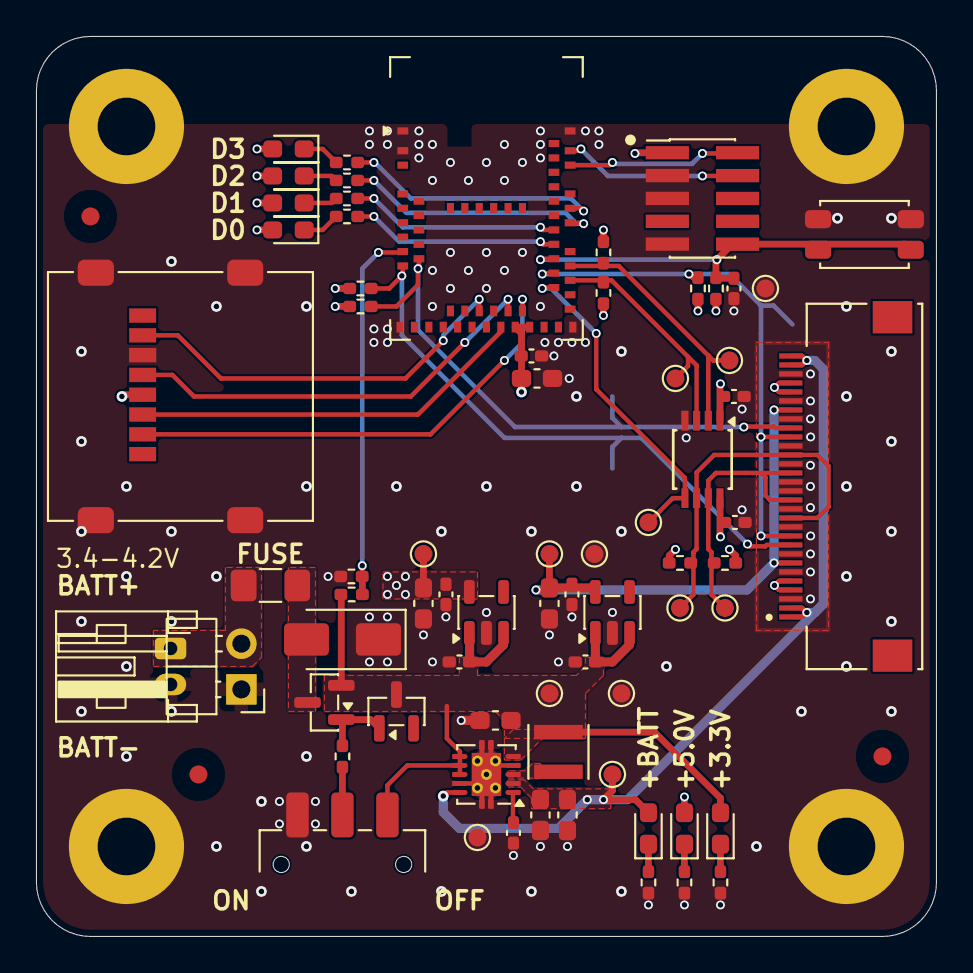
[picture p16: board kmm-pmask-control.kicad_pcb from above]

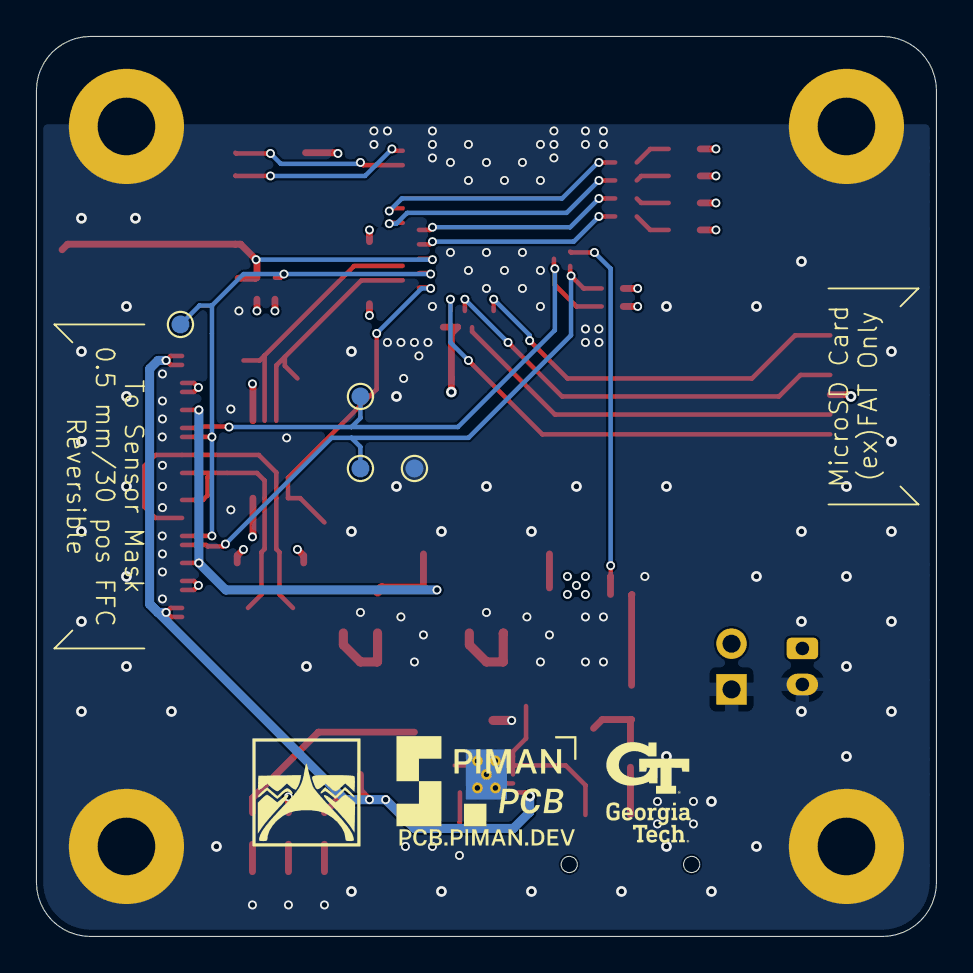
[picture p17: board kmm-pmask-control.kicad_pcb from below]

Board: 4 copper layers, 50.0 x 50.0 mm, 81 parts (4 on the bottom side), 38 nets.
