xinyew/Moamoa_CPAP_PI_hardware/(commit log)

2026-07-13 initial KiCAD setup
    [kmm-pmask-control.kicad_pcb, kmm-pmask-control.kicad_sch, kmm-pmask-mask.kicad_pcb, kmm-pmask-mask.kicad_sch]
2026-07-13 preliminary schematic for mask
    [kmm-pmask-mask.kicad_sch]
2026-07-13 preliminary placement for mask sensors
    [kmm-pmask-mask.kicad_pcb, kmm-pmask-mask.kicad_sch]
2026-07-13 tweak positions, move components away from edge
    [kmm-pmask-mask.kicad_pcb]
2026-07-13 fix incorrect I2C address note
    [kmm-pmask-mask.kicad_sch]
2026-07-13 Mostly annotate schematic
    [kmm-pmask-mask.kicad_pcb, kmm-pmask-mask.kicad_sch]
2026-07-13 Add test points
    [kmm-pmask-mask.kicad_pcb, kmm-pmask-mask.kicad_sch]
2026-07-13 add extra decoupling caps, pull-ups to placement
    [kmm-pmask-mask.kicad_pcb, kmm-pmask-mask.kicad_sch]
2026-07-14 initial routing
    [kmm-pmask-mask.kicad_pcb, kmm-pmask-mask.kicad_sch]
2026-07-14 Schematic annotations, power flags
    [kmm-pmask-mask.kicad_pcb, kmm-pmask-mask.kicad_sch]
2026-07-14 change stackup to 2 layers
    [kmm-pmask-mask.kicad_pcb]
2026-07-14 Add annotations of bus load
    [kmm-pmask-mask.kicad_pcb, kmm-pmask-mask.kicad_sch]
2026-07-14 tweak FFC cable pinout
    [kmm-pmask-mask.kicad_pcb, kmm-pmask-mask.kicad_sch]
2026-07-14 make top tab thinner
    [kmm-pmask-mask.kicad_pcb, kmm-pmask-mask.kicad_sch]
2026-07-14 track cleanup
    [kmm-pmask-mask.kicad_pcb, kmm-pmask-mask.kicad_sch]
2026-07-14 Silkscreen cleanup
    [kmm-pmask-mask.kicad_pcb]
2026-07-14 Add fiducials, missing 3D
    [kmm-pmask-mask.kicad_pcb, kmm-pmask-mask.kicad_sch]
2026-07-14 Production Candidate 1
    [kmm-pmask-mask-B_Cu.gbl, kmm-pmask-mask-B_Mask.gbs, kmm-pmask-mask-B_Paste.gbp, kmm-pmask-mask-B_Silkscreen.gbo, kmm-pmask-mask-B_Stiffener.gbr, kmm-pmask-mask-Edge_Cuts.gm1, kmm-pmask-mask-F_Cu.gtl, kmm-pmask-mask-F_Mask.gts]
2026-07-15 Add pull-ups for unused interrupt line, just in case
    [kmm-pmask-mask.kicad_pcb, kmm-pmask-mask.kicad_sch]
2026-07-15 Production Candidate 2
    [kmm-pmask-mask-B_Cu.gbl, kmm-pmask-mask-B_Mask.gbs, kmm-pmask-mask-B_Paste.gbp, kmm-pmask-mask-B_Silkscreen.gbo, kmm-pmask-mask-B_Stiffener.gbr, kmm-pmask-mask-Edge_Cuts.gm1, kmm-pmask-mask-F_Cu.gtl, kmm-pmask-mask-F_Mask.gts]
2026-07-15 minor track tweaks
    [kmm-pmask-mask-B_Cu.gbl, kmm-pmask-mask-B_Mask.gbs, kmm-pmask-mask-B_Paste.gbp, kmm-pmask-mask-B_Silkscreen.gbo, kmm-pmask-mask-B_Stiffener.gbr, kmm-pmask-mask-Edge_Cuts.gm1, kmm-pmask-mask-F_Cu.gtl, kmm-pmask-mask-F_Mask.gts]
2026-07-15 fix incorrect dates on sheets
    [kmm-pmask-mask.kicad_pcb, kmm-pmask-mask.kicad_sch]
2026-07-15 Add mask-side output drivers
    [MCU.kicad_sch, ext_conn.kicad_sch, kmm-pmask-control.kicad_sch, power.kicad_sch]
2026-07-15 WIP power circuitry
    [ext_conn.kicad_sch, kmm-pmask-control.kicad_pcb, power.kicad_sch]
2026-07-16 Initial draft of control board
    [MCU.kicad_sch, ext_conn.kicad_sch, kmm-pmask-control.kicad_sch, mech.kicad_sch, perhipherals.kicad_sch, power.kicad_sch]
2026-07-17 Fix incorrect documented I2C address
    [kmm-pmask-mask.kicad_sch]
2026-07-17 swap fuse for slow-blow
    [power.kicad_sch]
2026-07-17 Initial PCB Layout
    [MCU.kicad_sch, ext_conn.kicad_sch, kmm-pmask-control.kicad_pcb, mech.kicad_sch, perhipherals.kicad_sch, power.kicad_sch]
2026-07-17 Add missing vendor part specifiers
    [power.kicad_sch]
2026-07-19 Add manufacturing data
    [MCU.kicad_sch, ext_conn.kicad_sch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]
2026-07-19 update BOM to group correctly by value
    [kmm-pmask-control.csv, kmm-pmask-mask.csv]
2026-07-20 Add schematic PDF exports
    [kmm-pmask-control.kicad_pcb, kmm-pmask-mask.kicad_sch]
2026-07-20 add missing DigiKey part number
    [kmm-pmask-mask.csv]
2026-08-24 added M size mask and updated gitignore
    [kmm-pmask-mask.kicad_pcb, kmm-pmask-mask.kicad_sch]
2026-08-24 M size profile updated based on ordered XS size board
    [kmm-pmask-mask.kicad_pcb]
2026-08-24 M size silkscreen updated
    [kmm-pmask-mask.kicad_pcb]
